heitordemoraesfagundes-star/Project_MO/docs/03_Project_Identity/Project_Brand_Specification.md

# Project MO Brand Specifications

## Brand Identity — V1.0

### Project Name

**Project MO**

## Logo

### Design Concept

A friendly electronic companion represented through a minimalist, PCB-inspired face.

### Core Visual Elements

- Rounded PCB frame
- Continuous circuit traces
- Four corner connection pads
- Simple geometric eyes
- Minimal curved smile

## Primary Colors

| Color | Hex Code |
|---|---|
| MO Mint | `#72D6C1` |
| MO Charcoal | `#182126` |
| MO Teal | `#2D7772` |
| MO Cream | `#F4F1E8` |

## Logo Variants

The Project MO logo is designed in four primary variants:

- Primary
- Light
- Dark
- Monochrome
