heitordemoraesfagundes-star/Project_MO/docs/Development_Log/2026_08_18.md

# Project MO — Development Log

**Date:** 2026-08-18  
**Session:** Decision Log

## Objectives

- Create the Decision Log files
- Polish the files for better presentation

## Work Completed

- Created a Decision Log for all major decisions:
 - DL-001: Project Scope and V1 Definitions
 - DL-002: System Architecture
 - DL-003: Microcontroller Selection
 - DL-004: Interaction & Personality System
 - DL-005: Audio System Design
 - DL-006: Power System Design
 - DL-007: Mechanical & Enclosure Design
 - DL-008: Documentation & Repository Structure

## Decisions Made

- The major decisions were split into eight Decision Logs

## Problems/Blockers

- none

## Next Steps

- Continue with the next stage of Project MO development and implementation.
