heitordemoraesfagundes-star/Project_MO/docs/Development_Log/2026_08_25.md

# Project MO — Development Log

**Date:** 2026-08-25
**Session:** Faceplate Fastening & Front-Control Opening Design

## Objectives

* Complete the main-body and faceplate fastening system
* Verify alignment and interference between the main body, faceplate, and display
* Begin Goal 3 by defining the final front-panel control layout
* Create functional openings for the D-pad and three primary buttons
* Preserve adequate manufacturing clearance without unnecessarily changing the original control geometry

## Work Completed

* Added the following user parameters for the faceplate fastening system:

  * Boss outer diameter: 8 mm
  * Boss depth: 10 mm
  * Pilot-hole diameter: 2.6 mm
  * Pilot-hole depth: 8 mm
  * Screw-clearance diameter: 3.4 mm
* Created four mounting bosses inside the main body
* Positioned the boss centers 11 mm from the nearest side edges, with the two rows located 25 mm and 85 mm from the lower edge
* Added support ribs between the bosses and enclosure walls
* Corrected an extrusion that initially used `BodyDepth` instead of `BossDepth`
* Added four matching 3.4 mm through-holes to the faceplate
* Created construction axes through the corresponding body and faceplate holes
* Verified that matching axes have:

  * Distance: 0.00 mm
  * Angle: 0.00°
* Confirmed that the body and faceplate have no volumetric interference apart from intended coincident contact surfaces
* Confirmed that the display does not interfere with the body or faceplate
* Created a Fusion 360 version checkpoint for the completed Goal 2 assembly
* Completed Goal 2: Main Body and Faceplate
* Began Goal 3 by refining the front-panel layout using the original video as a visual reference
* Imported and positioned the original mesh models for:

  * D-pad
  * Large circular button
  * Small circular button
  * Triangular button
* Changed the display appearance to green and used the Shaded visual style to improve visibility
* Established the approximate control-center positions on the faceplate
* Confirmed that each button uses a narrow stem through the faceplate and a wider retaining flange behind it
* Created local mesh copies because linked mesh components could not be selected by the Mesh Section Sketch tool
* Generated mesh-section sketches for the button stems at the faceplate plane
* Applied 0.30 mm radial clearance to the D-pad and triangular-button profiles
* Corrected the circular measurements after identifying that the first sections referenced the larger retaining flanges rather than the narrow stems
* Defined the circular control openings as:

  * Large circular button: 18.6 mm diameter
  * Small circular button: 10.6 mm diameter
* Copied the completed opening profiles into the `Face_Plate` file
* Cut the D-pad, triangular, small-circle, and large-circle openings through the faceplate
* Visually verified clear gaps between the button stems and their corresponding openings
* Confirmed that the larger exterior caps and retaining flanges remain wider than their openings
* Completed the screen opening and all four primary control openings for Goal 3

## Decisions Made

* Four M3 fasteners will be used to secure the faceplate to the main body
* The body will use 8 mm bosses with 2.6 mm pilot holes, while the faceplate will use 3.4 mm clearance holes
* Goal 2 is considered complete following alignment, interference, and display-fit verification
* The original button meshes will remain reference components rather than being converted into production solids
* Button openings will be based on the narrow pass-through stems, not the exterior caps or retaining flanges
* A nominal radial clearance of 0.30 mm will be used around the button stems
* Minor asymmetry in the triangular opening is acceptable because it follows the original mesh geometry and remains hidden beneath the button cap
* Visual clearance verification is acceptable for the mesh buttons because Fusion 360 cannot reliably include the linked mesh components in normal interference checks
* Goal 3 will remain in progress until the remaining front-panel slot and lower port openings are completed

## Problems/Blockers

* The mounting bosses initially passed through the enclosure because the extrusion accidentally referenced `BodyDepth` rather than `BossDepth`
* Linked button meshes could not be selected using Create Mesh Section Sketch
* Fusion 360 did not provide an Edit in Place option for the linked mesh components
* Temporary local mesh copies were required to generate the button section profiles
* The first circular section measurements captured the retaining flanges instead of the narrower button stems
* The triangular mesh produced a slightly asymmetric fitted profile
* Normal interference checks could not be performed between the faceplate and the linked mesh buttons
* Final physical fit will still depend on real 3D-printing tolerances

## Next Steps

* Save a clean Fusion 360 version containing the completed control openings
* Finish Goal 3 by adding the horizontal slot below the display
* Add the two lower rectangular port openings
* Decide whether V1 requires a separate microphone or status-indicator opening
* Verify the complete front-panel layout against the original visual reference
* Consider printing a small control-opening test coupon before printing the complete faceplate
* After completing Goal 3, begin Goal 4: External Parts
