heitordemoraesfagundes-star/Project_MO/docs/Development_Log/2026_08_29.md

# Project MO — Development Log

**Date:** 2026-08-29  
**Session:** Goal 5 Completion & Goal 6 Assembly/Serviceability Review

## Objectives

* Complete the remaining internal hardware mounts and ventilation features for Goal 5
* Verify that the electronic modules can be installed, removed, and serviced in a practical order
* Confirm button travel, perfboard retention, and cable-connector clearance
* Create and validate the D-pad center pivot
* Complete the first Goal 6 assembly and serviceability checkpoint

## Work Completed

* Completed the 40 mm speaker mounting system using a side cradle aligned with the speaker grille
* Created a snap-style mount for the MAX98357A amplifier near the speaker
* Modeled the button perfboard using the provisional 111.76 × 50.8 × 1.6 mm dimensions
* Positioned seven tactile-switch references beneath the four front controls
* Created 1.5 mm-deep button-flange recesses while preserving 1.5 mm of front-wall material
* Added perfboard standoffs and pilot holes for removable screw fastening
* Added two circular speaker grilles with 37 holes each
* Added rear ventilation using two banks of six horizontal slots
* Verified that the USB opening remains accessible and that the FacePlate can be removed without interference
* Deferred dedicated cable clips and channels to V2 after confirming that flexible wiring can be routed without blocking service access
* Defined the main-body installation order as:

  1. Speaker
  2. Amplifier
  3. ESP32
  4. Display
  5. Display upper retainer
* Defined the FacePlate subassembly order as buttons first, followed by the perfboard
* Confirmed that the display should be removed before servicing the speaker or amplifier
* Confirmed that the ESP32 remains independently accessible
* Added a provisional 15 × 10 × 8 mm connector-clearance volume beneath the perfboard
* Confirmed space for an inward-facing detachable perfboard connector and a flexible 40–50 mm service loop
* Tested the circular and triangular buttons with 0.5 mm of simulated travel and confirmed correct switch engagement
* Measured the D-pad center socket as approximately 2.4 × 2.4 mm with a depth of 2.2 mm
* Measured 5.3 mm from the D-pad underside to the perfboard and defined a 7.5 mm total pivot height
* Created `DPad_Center_Pivot` with:

  * Ø2.0 mm stem
  * 7.5 mm total height
  * 0.8 mm rounded top fillet
  * Ø5 × 1 mm adhesive base flange
* Tested the D-pad at ±2° around both horizontal axes
* Confirmed that each rocking direction activates only one tactile switch
* Confirmed that the D-pad pivot flange does not interfere with the switches
* Verified perfboard screw access and completed the full assembly/serviceability review
* Saved the checkpoint `Goal 6A – Assembly and Serviceability Review Complete`

## Decisions Made

* The speaker, amplifier, ESP32, display, and display retainer will use a deliberate service order rather than being treated as simultaneously accessible
* The display must be removable without disturbing the FacePlate button subassembly
* The perfboard connection will use a detachable inward-facing connector with a flexible service loop
* Dedicated internal cable clips will be deferred to V2 unless physical assembly testing shows that they are necessary
* The D-pad requires a separate center pivot attached to the perfboard
* The D-pad pivot will use a wide adhesive flange so the narrow stem remains stable during repeated use
* Goal 5 is considered complete following the internal-mount, ventilation, connector-access, and interference checks

## Problems/Blockers

* The D-pad did not include a suitable central support in the original button geometry
* The pivot height had to account for both the 2.2 mm socket depth and the measured 5.3 mm gap to the perfboard
* Internal serviceability requires the display to be removed before accessing the speaker and amplifier
* Exact connector dimensions and the final service-loop length must still be verified using the purchased hardware
* The electronic reference models remain provisional and must be checked against the physical components before production printing

## Next Steps

* Begin the Goal 6 manufacturing-readiness review
* Check minimum wall thicknesses, snap clips, screw bosses, and reinforcement fillets
* Verify print orientation and support requirements for every printable component
* Standardize the arm and leg mounting interfaces where practical
* Finalize screw lengths and clearance-hole dimensions
* Run a final full-assembly interference check
* Export the verified print-ready meshes
