heitordemoraesfagundes-star/Project_MO/docs/Development_Log/2026_08_30.md

# Project MO — Development Log

**Date:** 2026-08-30  
**Session:** Goal 6 Manufacturing Readiness, Mesh Export & Print Validation

## Objectives

* Complete the enclosure manufacturing-readiness review
* Verify walls, snap features, bosses, fasteners, limb connections, and FacePlate clearance
* Establish print orientation and support requirements for every V1 part
* Export and organize the final mesh package
* Validate all meshes in PrusaSlicer
* Create a consolidated specification for requesting professional 3D-printing quotes

## Work Completed

* Verified the principal enclosure walls and FacePlate inner wall at 3.0 mm
* Confirmed 1.5 mm of remaining material beneath the button-flange pockets
* Confirmed approximately 1.5 mm minimum spacing around the grille and ventilation openings
* Increased the ESP32 and amplifier snap-hook thicknesses from 0.8 mm to 1.2 mm
* Added 0.4 mm root fillets to the strengthened snap hooks
* Rechecked both snap mounts and confirmed no PCB interference
* Verified a representative screw boss with:

  * 8 mm outer diameter
  * Ø2.6 mm pilot hole
  * Approximately 2.7 mm radial wall thickness
* Applied 0.8 mm fillets only to true concave FacePlate boss-rib junctions
* Rejected fillets on convex enclosure edges when the preview removed material and weakened the geometry
* Used draft and section analysis to review the enclosure walls, internal features, and manufacturing direction
* Established the main-body print orientation with the flat rear exterior on the build plate and the open front upward
* Established the FacePlate print orientation with the visible exterior on the build plate and internal protrusions upward
* Established flat print orientations for the display retainer, button parts, and D-pad pivot
* Established side orientations for both arms and broad-side orientations for both legs
* Standardized the leg peg insertion length from 2.5 mm to 3.0 mm to match the arm connection depth
* Changed the leg sockets to cut through the complete 3 mm enclosure wall
* Confirmed no overlap after the leg-interface revision
* Verified the final limb interfaces as:

  * Arm peg: 6 × 6 × 3 mm
  * Arm socket: 6.4 × 6.4 mm through the 3 mm wall
  * Leg peg: 5 × 5 × 3 mm
  * Leg socket: 5.6 × 5.6 mm through the 3 mm wall
* Confirmed the FacePlate perimeter clearance as 0.50 mm per side on all sides
* Finalized the screw schedule:

  * FacePlate: M3 × 10 mm self-tapping/thread-forming screws
  * Display retainer: M3 × 8 mm self-tapping/thread-forming screws
  * Button perfboard: M2 × 5 mm self-tapping/thread-forming screws
* Verified the corresponding clearance holes:

  * FacePlate and display retainer: Ø3.4 mm
  * Perfboard: Ø2.4 mm
* Confirmed the main-body Ø2.6 mm pilot holes for the M3 screws
* Ran the final assembled interference check and found no interference
* Cleaned the export assembly by hiding construction geometry, analysis overlays, and electronic reference components
* Exported the following new parts as high-refinement 3MF files in millimeters:

  * `Project_MO_Main_Body_V1.3mf`
  * `Project_MO_FacePlate_V1.3mf`
  * `Project_MO_Display_Upper_Retainer_V1.3mf`
  * `Project_MO_DPad_Center_Pivot_V1.3mf`
  * `Project_MO_Left_Arm_V1.3mf`
  * `Project_MO_Right_Arm_V1.3mf`
  * `Project_MO_Left_Leg_V1.3mf`
  * `Project_MO_Right_Leg_V1.3mf`
* Renamed the existing original button meshes to match the Project MO V1 naming convention
* Organized the production meshes under `hardware/enclosure/V1_Final/`
* Saved the Fusion checkpoint `Goal 6B – Manufacturing Review and Mesh Export Complete`
* Used an Original Prusa XL 5T 0.4 mm profile as a temporary large-bed inspection profile
* Disabled the automatically generated wipe tower because the project will be sent to a professional printing service rather than exported as G-code
* Completed PrusaSlicer validation for every printable part:

  * Main body: rear exterior down; targeted support required beneath the lower speaker cradle
  * FacePlate: exterior down; no support required
  * Display upper retainer: flat; no support required
  * D-pad center pivot: flange down; no support required; three copies recommended
  * Arms: side-down; build-plate organic/tree support recommended
  * Legs: broad-side-down; build-plate support and brim required
  * All four buttons: retaining flange down; no support required
* Selected PETG as the preferred V1 printing material
* Defined the quote specification as:

  * FDM/FFF process
  * 0.4 mm nozzle
  * 0.20 mm layer height
  * Four perimeters
  * 20% gyroid infill
  * Five top and bottom layers
  * 100% scale
* Created `Project_MO_V1_3D_Printing_Specification.pdf` containing quantities, orientations, support instructions, critical dimensions, fasteners, and quality requirements

## Decisions Made

* PETG will be requested for the complete V1 printed-parts quote because it provides better toughness and heat resistance than PLA for snap clips, screw bosses, and limb pegs
* The final production package will use 3MF mesh files rather than client-generated G-code
* The original buttons will retain their existing mesh geometry and will not be redundantly re-exported from Fusion
* Left and right arm and leg parts will remain separate replacement files
* The main body requires support only beneath the speaker cradle according to the slicer validation; the display ledge was accepted as printable without generated support
* Arms require support because of their curved undersides, while legs require both support and a brim because of limited bed contact
* Three D-pad center pivots will be ordered because the part is small and easy to lose
* The full enclosure should not be ordered until the exact purchased electronics have been verified

## Problems/Blockers

* The initial default PrusaSlicer printer profile was too small for the approximately 150 × 200 × 60 mm enclosure and produced an out-of-bounds warning
* The temporary XL 5T profile generated a wipe tower that had to be disabled because only single-material geometry inspection was required
* The arm and leg meshes retained their Fusion assembly orientations and required reorientation in PrusaSlicer
* Both arms produced floating-feature warnings without support
* Both legs produced floating-bridge, loose-extrusion, and low-bed-adhesion warnings without support and a brim
* Exact dimensions of the purchased display, ESP32, amplifier, speaker, perfboard, and connectors remain unverified
* A professional 3D-printing supplier and final printing price have not yet been selected

## Next Steps

* Verify the exact purchased components and compare their measurements with the provisional CAD references
* Update any affected mounts or clearances before ordering the full enclosure
* Create or order a small functional fit sample for the limb sockets, button clearance, and screw pilots
* Identify professional 3D-printing suppliers and request comparable PETG quotes using the mesh package and printing specification
* Update the BOM with the selected supplier, material, quantity, price, shipping, and lead time
* Upload the final manufacturing package and both Development Logs to the Project MO GitHub repository
* Continue to physical fit testing, electronics assembly, wiring, firmware, and final documentation after the printed parts arrive
