heitordemoraesfagundes-star/Project_MO/docs/Development_Log/2026_09_11.md

# Project MO - Development Log

**Date:** September 11, 2026  
**Session focus:** Printable-solid verification, 3MF validation, and V1 manufacturing-release packaging

## Session objective

Convert the completed enclosure design into a clear and reproducible manufacturing package by standardizing part names, verifying every revised printable solid, validating the final 3MF exports in PrusaSlicer, preserving the editable Fusion assembly, and updating the production documentation.

## Work completed

### 1. Printable-part naming and organization

- Standardized the principal enclosure-part names around the `Project_MO_V1` naming convention.
- Confirmed the final part identities for:
  - Main Body
  - FacePlate
  - Display Upper Retainer
  - Four position-specific Perfboard Retainers
  - D-pad, large circular, small circular, and triangle buttons
  - D-pad Center Pivot
  - Left and right arms
  - Left and right legs
- Organized the four perfboard retainers as four independent top-level components.
- Assigned the retainer locations as viewed from the inside of the FacePlate:
  - `Perfboard_Retainer_Upper_Left`
  - `Perfboard_Retainer_Upper_Right`
  - `Perfboard_Retainer_Lower_Left`
  - `Perfboard_Retainer_Lower_Right`
- Used visibility isolation to confirm that each retainer is an independent printable solid.

### 2. FacePlate and Main Body release checks

- Confirmed that the FacePlate contains one production body and no reference solid inside its Bodies folder.
- Rechecked the FacePlate interfaces:
  - FacePlate-to-body clearance holes: **3.4 mm**
  - Perfboard support-boss outer diameter: **7.0 mm**
  - Perfboard support-boss pilot diameter: **1.6 mm**
  - Pilot/support depth: **4.5 mm**
- Confirmed that all control, display, switch, and screw openings pass through as intended.
- Confirmed that the Main Body contains one production body and no reference solid inside its Bodies folder.
- Rechecked the Main Body interfaces:
  - Main switch cutout: **20.0 mm**
  - FacePlate mounting pilots: **2.6 mm**
  - Overall slicer envelope: approximately **150 x 200 x 65 mm**
- Verified that the Main Body vents, USB opening, internal supports, and mounting features remained present in the production export.

### 3. Display Upper Retainer verification

- Renamed the source design `Project_MO_V1_Display_Upper_Retainer`.
- Confirmed that it contains one continuous production body.
- Confirmed both mounting holes at **3.4 mm diameter**.
- Confirmed that the continuous bar and both lower contact/support pads remain attached.
- Found no timeline warnings or unintended reference solids.

### 4. Perfboard-retainer manufacturing checks

- Confirmed all four M2 clearance holes at **2.2 mm diameter**.
- Confirmed the added **R2.0 mm side fillets**.
- Measured approximately **2.90 mm** of minimum side material around the inspected mounting hole.
- Measured approximately **2.759 mm** of minimum bottom material around the inspected mounting hole.
- Finalized the retainer overlap onto the perfboard at **2.929 mm**.
- Confirmed that this overlap does not cover any required solder pad.
- Approved all four retainers as separate manufacturing-ready solids.

### 5. Individual 3MF export

- Exported every perfboard retainer as an individual 3MF file.
- Re-exported the four control bodies from the shared Fusion button document as true 3MF files:
  - D-pad Button
  - Large Circular Button
  - Small Circular Button
  - Triangle Button
- Retained one D-pad Center Pivot file with a required print quantity of three.
- Re-exported the updated Main Body, FacePlate, and Display Upper Retainer.
- Reused the previously verified arm and leg exports because those designs had not changed.

### 6. PrusaSlicer validation

- Imported the four perfboard retainers together and confirmed that PrusaSlicer recognized four independent objects.
- Sliced the retainers successfully with open screw holes, connected tabs, and no floating toolpaths.
- Imported and sliced all four buttons as separate objects with their retaining flanges on the build plate.
- Confirmed complete button toolpaths, no floating geometry, and no required support.
- Imported and sliced the D-pad Center Pivot with its flange on the bed and stem vertical.
- Confirmed that the pivot slices as one continuous part; retained an optional small brim recommendation for the real print.
- Imported and sliced the Main Body with the rear exterior on the build plate and open side upward.
- Confirmed the Main Body at approximately **65 mm** print height with complete walls, vents, openings, and internal mounts.
- Imported and sliced the FacePlate with its visible exterior on the bed and internal bosses upward.
- Confirmed all FacePlate openings and bosses in the sliced preview with no support required.
- Imported and sliced the Display Upper Retainer with complete holes and connected support tabs.
- Treated the unchanged arms and legs as still valid based on their previous completed verification.

### 7. Final manufacturing-folder organization

- Organized `hardware/enclosure/V1_Final/` into:
  - `3MF_Final`
  - `Legacy_STL`
  - `Old_Versions`
  - `Fusion_Source`
- Moved the four older STL button exports into `Legacy_STL`.
- Moved superseded Main Body and Display Upper Retainer 3MF exports into `Old_Versions`.
- Confirmed that `3MF_Final` contains **16 unique production 3MF files**.
- Confirmed that the file set produces **18 physical pieces** because the D-pad Center Pivot is printed three times.

### 8. Editable Fusion archive

- Created the final Fusion version checkpoint for the manufacturing-release candidate.
- Used the Autodesk Fusion web project interface to request a native Fusion Archive export.
- Downloaded the linked assembly as an F3Z archive.
- Renamed the archive:
  - `Project_MO_V1_Manufacturing_Release.f3z`
- Confirmed the archive as a valid Autodesk Fusion file with a size of approximately **10.7 MB**.
- Assigned the archive to the `Fusion_Source` folder so that the editable assembly and linked references remain preserved.

### 9. Manufacturing documentation update

- Created `PRINT_MANIFEST.md` containing:
  - All 16 final 3MF filenames
  - Required quantity for every part
  - Total of 18 physical pieces
  - Editable F3Z archive location
  - Final interface dimensions and verification status
- Updated the original 3D Printing Specification from Revision 1.1 to **Revision 1.2**.
- Added the four perfboard retainers and updated the final quantities.
- Updated the button-perfboard fastener specification from the obsolete M2 x 5 mm / 2.4 mm arrangement to:
  - **M2 x 8 mm screws**
  - **2.2 mm retainer clearance holes**
  - **1.6 mm x 4.5 mm FacePlate pilots**
  - Approximately **4.4 mm thread engagement**
- Updated the main enclosure envelope to approximately **150 x 200 x 65 mm**.
- Added the finalized **2.929 mm perfboard overlap** and retainer material checks.
- Added the **20.0 mm switch cutout**, approximately 19.6 mm switch body, 22.9 mm flange, and provisional internal clearance envelope.
- Removed the obsolete STL meter-to-millimetre correction warning because the final button files are true 3MF exports at the correct scale.
- Added final release-package, verification, and pre-production validation notes.

## Decisions made

1. Treat **2.929 mm** as the final V1 perfboard-retainer overlap because it does not obstruct required solder pads.
2. Store each position-specific perfboard retainer as a separate 3MF file.
3. Keep one editable Fusion source document containing all four retainer components.
4. Use 3MF as the final production mesh format and retain the old STL files only as legacy backups.
5. Maintain 16 unique production files and print the D-pad Center Pivot three times for 18 total pieces.
6. Reuse the previously verified arm and leg exports because their geometry has not changed.
7. Preserve the complete linked Fusion assembly as an F3Z archive.
8. Keep cable-management additions outside the V1 manufacturing release.

## Verification status

| Item | Status |
| --- | --- |
| Four perfboard retainers are separate solids | Passed |
| Perfboard-retainer final overlap | 2.929 mm approved |
| Required solder pads remain accessible | Passed |
| Four retainers re-imported and sliced | Passed |
| Four buttons re-imported and sliced | Passed |
| D-pad Center Pivot re-imported and sliced | Passed |
| Main Body re-imported and sliced | Passed |
| FacePlate re-imported and sliced | Passed |
| Display Upper Retainer re-imported and sliced | Passed |
| Arms and legs | Previously verified; unchanged |
| Final production mesh count | 16 unique 3MF files |
| Total printed-piece count | 18 |
| Final Fusion archive | F3Z export completed |
| Printing manifest | Completed |
| Printing specification | Updated to Revision 1.2 |

## Final release files

- `3MF_Final/` - 16 approved production meshes
- `Fusion_Source/Project_MO_V1_Manufacturing_Release.f3z`
- `PRINT_MANIFEST.md`
- `Project_MO_V1_3D_Printing_Specification_Rev1.2_EN.pdf`
- `Legacy_STL/` - backup only
- `Old_Versions/` - backup only

## Remaining work

- Copy the completed Development Logs into the project documentation structure and commit the release documentation to GitHub.
- Obtain and physically measure the selected power switch, especially its total depth and terminal projection.
- Receive and inspect the exact display, ESP32, amplifier, speaker, microphone, perfboard, and other purchased components.
- Print small fit coupons for the 20 mm switch opening, screw pilots, button clearances, and limb peg/socket interfaces where practical.
- Request or compare professional printing quotes using Revision 1.2 of the specification.
- Complete component-arrival and bench testing before final assembly.

## Session outcome

Project MO V1 reached the manufacturing-release-candidate stage. Every changed printable part was organized, exported as a real 3MF file, re-imported, and successfully sliced. The unchanged limbs retained their previous verification. The production folder now contains a controlled 16-file mesh set for 18 printed pieces, older exports are separated from production files, the linked Fusion assembly is preserved as an F3Z archive, and the printing specification and manifest reflect the final V1 mechanical design.
