heitordemoraesfagundes-star/Project_MO/docs/Development_Log/2026_08_01.md

# Project MO — Development Log

**Date:** 2026-08-01  
**Session:** Engineering Decisions

## Objectives

- Decide the project main controller

## Work Completed

- Decided main controller

## Decisions Made

- Main controller: ESP32

## Problems / Blockers

- Controler must handle multiple pheripherals while remaining affordable

## Next Steps

-  Write PDS document
