heitordemoraesfagundes-star/Project_MO/docs/Development_Log/2026_08_02.md

# Project MO — Development Log

**Date:** 2026-08-02  
**Session:** Product Design Specification

## Objectives

- Write PDS document

## Work Completed

- Created PDS document 

## Decisions Made

- Decided desing oriention

## Problems / Blockers

- None

## Next Steps

- Create BOM file.
- Choose first components.
- Decide all necessary information.
