heitordemoraesfagundes-star/Project_MO/docs/Development_Log/2026_08_06.md

# Project MO — Development Log

**Date:** 2026-08-06  
**Session:** BOM_Final_Version

## Objectives

- Complete the missing details on the BOM.
- Add additional components.
- Add unit price, weight, supplier and link to every .

## Work Completed

- Filled the missing details.
- Added C-020 to C-028.
- Added unit price, weight, supplier and link.

## Decisions Made

- All 3D prited parts will have their price added only after modifications.
- All 3D printed parts should come from the same supplier if possible.

## Problems / Blockers

- Some item's weight needed to be estimated.
- 3D printed parts price couldn't be filled.

## Next Steps

- Finish 3D part modification to fill in the missing details.
- Create GitHub repository structure.
- Draft the project README.
