heitordemoraesfagundes-star/Project_MO/docs/02_Design/Hardware_Specification_Document.docx

Hardware Selection Document(HSD):

1. Hardware Philosophy:

#Design Goals:

-low cost;

-high reliability;

-easy to programm;

-easy to replace;

-modular design;

-expandable for future versions.

2. System Overview:

#The robot can be divided into six main hardware systems:

-power system;

-main controller;

-input;

-output;

-communication;

-mechinical structure.

3. Main controller(ESP32 DevKit V1):

#Pros:

-cheap;

-Wi-fi and Bluetooth connection;

-dual-core processor;

-plenty GPIO pins;

-huge community;

-compatible with arduino IDE;

-lower power consumption;

-easy to replace/upgrade.

#Cons:

-unnable to run AI models.

4. Display System(2.4 inch TFT LCD):

#Pros:

-color;

-larger animations;

-better face expression and better visual appeal.

#Cons:

-slightly more expensive than other options(R$50-50)

5. Audio System(DF Player_Mini + Speaker):

#Pros:

-plays MP3 files;

-easy to program;

-excellent sound;

-SD card storage;

-very common;

#Cons:

-requires audio files to be recorded beforehand.

6. Input System:

#Buttons:

-start;

-menu;

-confirm;

-personality;

-games(future addition).

7. Sensors:

#Ultrasonic Sensor(HC-SR04):

-detect user approaching;

-eye traking (possible future addition).

#Touch sensor:

-for future additions

#Light Sensor:

-know the diffeence between lights on and off;

-not essencial;

#Microphone:

-for future versions;

8. Lighting:

#WS2812B RGB LEDs:

-programabble;

-colorful;

-enhances personality;

-low cost.

#Possible uses:

-charging animation;

-mood;

-startup animation.

9. Power:

#USB-C (for V1-V2):

-simple;

-reliable;

-easy debugging;

#Battery (for V2-V3):

-makes the robot more portable;

10. Mechinical Components:

-M3 screws;

-brass heat-set inserts;

-magnets/hidden screws (for easy maintenance);

-small standoff/spacers;

-cable ties or adhesive clips for cable managing.

11. Debbug mode:

-add debug mode to check connections.
