heitordemoraesfagundes-star/Project_MO/docs/02_Design/Mechanical_Design_Specification.docx

## Mechanical Design Specification (MDS)

### Mechanical Requirements

- Display must be removable.
- No permanent glue for major components.
- Speaker accessible.
- Cable routing channels.
- Easy maintenance.
- Rear panel removable.
- Components mounted with screws whenever possible.

Mechanical Architecture:

## Module A

### Display Module

Contains:

- TFT Display
- Faceplate
- Mounting Frame

This module should be removable independently.

## Module B

### User Interface Module

Contains:

- Front Buttons
- Push Mechanisms
- PCB (future)

## Module C

### Main Electronics Module

Contains:

- ESP32
- DFPlayer
- Voltage Distribution
- Connectors

## Module D

### Audio Module

Contains:

- Speaker
- Acoustic Chamber

## Module E

### Rear Service Panel

Contains:

- USB
- Power
- SD Card Access

Modifications:

1. The front buttons:

-Instead of:

*button -> switch;

-Use:

*button -> spring -> guide -> microswitch;

*smoother feel + consistent travel + easier replacement;

2. Cable routing:

-Clear and easily replicable;
