heitordemoraesfagundes-star/Project_MO/docs/02_Design/Project_Brand_Specification.docx

Project MO Brand Specifications:

PROJECT MO

Brand Identity — V1.0

Project Name:

Project MO

Logo:

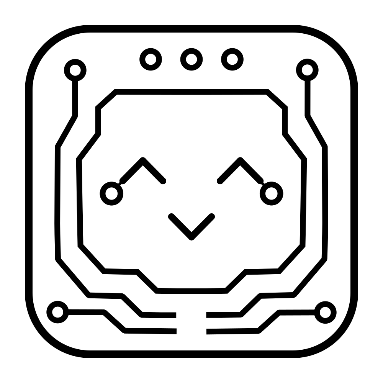
[picture p1: figure]
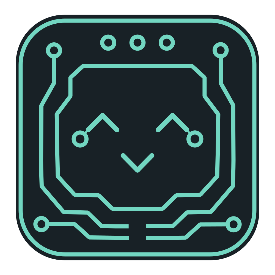
[picture p2: figure]
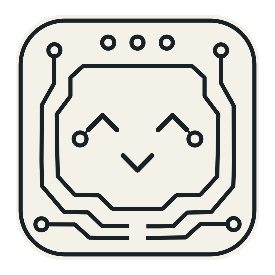
[picture p3: figure]
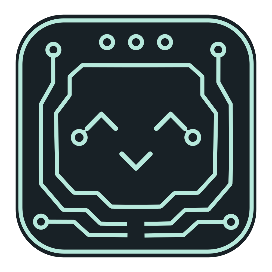
[picture p4: figure]

Design Concept:

A friendly electronic companion represented through

a minimalist PCB-inspired face.

Core Visual Elements:

• Rounded PCB frame

• Continuous circuit traces

• Four corner connection pads

• Simple geometric eyes

• Minimal curved smile

Primary Colors:

MO Mint #72D6C1

MO Charcoal #182126

MO Teal #2D7772

MO Cream #F4F1E8

Logo Variants

• Primary

• Light

• Dark

• Monochrome
