heitordemoraesfagundes-star/Project_MO/docs/02_Design/System_Design_Document.docx

System Design Document(SDD):

1. System Overview:

#Purpose:

The purpose of this system is to develop an interactive robotic prototype inspired by the BMO character from Adventure Time. The system will integrate mechenical design, enbedded electronics and software programming to create a device cappable of interacting with users trough visual, audio and physical interfaces;

2. System Architecture:

-The robot will be divided into five major subsystems:

USER

↓

Interaction Interface

↓ ↓ ↓

Buttons Sensors Microphone

↓

ESP32 Controller

↓ ↓ ↓

Display Audio Lighting

3. Hardware Architecture:

a) Main controller:

-ESP32 Microcontroller

#Functions/Responsibilities:

-The main controller will:

*process user inputs;

*control outputs;

*manage communication between components;

*execute the robots personality logic;

#Reasons for selection:

-The ESP32 was selected because it provides:

*sufficient processing power;

*low cost;

*Integrated Wi-fi/Bluetooth;

*compatibility with many sensors and modules.

b) Visual interface system:

#Possible components:

-OLED display;

-LCD display;

-LED indicators;

#Functions/Responsibilities:

-facial expression;

-animations;

-status indications;

c) Audio System:

#Possible components:

-speaker;

-audio module;

#Fuctions/Responsibilities:

-programmed responses;

-sound effects;

-notifications;

d) Input system:

#Possible components:

-Physical buttons;

-Distance sensor;

-Microphone;

# Fuctions/Responsibilities:

-menu selections;

-trigger responses;

-detect user presence;

-voice interaction;

e) Power system:

#Baterry powered X USB powered:

-USB power:

*easier debugging;

*safer;

*simpler;

4. Sofware Architecture:

a)Input processing:

#Receive:

-button presses;

-sensor data;

b)Personality engine

#Situation -> Response:

-Example:

-single button press = happy expression;

-repeated button presses = angry/ anoyed expression;

c) Output control:

#Controls:

-display;

-audio;

-leds.

5. Personality design:

a)Happy:

#Visual:

-smiling face :) ;

#Audio:

-cheerful response;

b) Curious:

#Visual:

-thinking expression;

#Audio:

-question/comment;

-fun trivia/information;

c) Angry:

#Visual:

-angry expression >:( ;

#Audio:

-irritated/annoyed voice;

d)Sleep mode:

#Visual:

-closed eyes;

#Audio:

-no audio/ snoring sound;

6. Possible future improvements:

#Possible additions:

-voice recognition;

-AI integration;

-autonomous behaviour;

-wireless comunication;

-custom PCB
