heitordemoraesfagundes-star/Project_MO/research/Inspiration.docx

Original video name:

# “I made a real BMO local AI agent with a Raspberry Pi and Ollama”

# Original video link:

https://youtu.be/l5ggH-YhuAw?si=dqu8FAm8gZTQALl-

Creators name: “brenpoly”
