heitordemoraesfagundes-star/Project_MO/docs/Development_Log/2026_08_17.md

# Project MO — Development Log

**Date:** 2026-08-17  
**Session:** Repository Organization

## Objectives

- Finalize the Project MO README.
- Make sure the README accurately reflects the current repository structure.
- Organize the project documentation on GitHub.
- Establish a system for recording daily development progress.
- Establish a system for recording important project and engineering decisions.

## Work Completed

- Uploaded all six completed project documents to GitHub.
- Converted the project documents from .docx to .md.
- Organized the documents into appropriate documentation categories
- Verified that the README links are working correctly.
- Established the planned Development_Log folder for chronological project records.
- Established the planned Design_Decisions folder for important project decisions.

## Decisions Made

- Markdown will be used for the main text-based documentation on GitHub.
- The README will serve as the main entry point to the Project MO repository.
- Development sessions will be recorded using individual dated Markdown files.
- Important decisions will be recorded separately from daily development logs.
- The README will be treated as a living document and updated as Project MO develops.
- The V1 scope remains focused on a stationary desktop companion, with movement outside the scope of V1.
- The repository will keep the Project MO name and finalized logo as its project identity.

## Problems/Blockers

- none

## Next Steps

- Create the Design_Decisions folder and begin documenting major decisions already made.
- Continue reviewing the repository structure and improve it where necessary.
- Begin preparing for the mechanical design phase.
- Identify all modifications required to the existing BMO-inspired 3D model before calculating final 3D-printing costs.
- Eventually begin the enclosure modification and prototyping process.
