heitordemoraesfagundes-star/Project_MO/BOM/Project_MO_V1_Components_BOM_Rev1.12.xlsx

ID | Subsystem | Component | Purpose | Selected Part | Qty | Priority | Purchased | Tested | Notes | Unit Price(BRL) | Supplier | Link | Weight (grams) | Connection/Interface
C-001 | Control | Microcontroller | Main system controller | DOIT ESP32 ESP-WROOM-32 DevKit V1, 30-pin, CP2102, Micro-USB | 1 | Required | Yes — received | Passed — USB/serial and firmware upload | Physical board received and identified as a DOIT ESP32 DEVKIT V1 with the classic ESP32 module and 30-pin layout. Arduino IDE 2.3.10 was configured with the official Espressif esp32 package 3.3.11. The board was detected on COM3; firmware upload, Serial Monitor communication and the Project MO command prototype all passed. Physical measurement and enclosure fit confirmation remain pending. | BRL 59.90 | SARAVATI | https://www.saravati.com.br/placa-esp32-wifi-bluetooth-devkit-v1-30-pinos.html | TBD after purchase | Micro-USB / GPIO / UART / I²S
C-002 | Display | HMI Display | Face animations and user interface | Nextion Intelligent 5.0-inch NX8048P050-011R resistive HMI, 800 x 480, without enclosure | 1 | Required | No | No | Final display selected. PCB: 136.9 x 84.0 mm; LCD outline: 120.7 x 75.8 mm; active area: 108.0 x 64.8 mm; approximately 130 g; 5 V / 1 A recommended supply; XH2.54 4-pin UART (GND, RX, TX, +5 V). CAD fit, active-area alignment, supports, retainer, plug and filleted cable route verified. Minimum plug/cable clearance to the display support is 4.10 mm; no body or speaker interference; display can be inserted with the cable attached. Price converted using BCB rate of BRL 5.1273006 per USD on 2026-09-02: USD 63.90 = BRL 327.66. Checkout with standard shipping: USD 74.51 = BRL 382.05; plus BRL 15 Correios fee gives BRL 397.05 before possible import taxes, card spread and IOF. | BRL 327.66 | ITEAD official store | https://itead.cc/product/5-0-nextion-intelligent-series-hmi-touch-display/ | ~130 g | XH2.54 4-pin UART + 5 V; microSD up to 32 GB
C-003 | Audio | Speaker | Audio output | 40CCG08HX, 40 mm diameter, 19 mm depth, 8 ohm, 3 W nominal | 1 | Required | No | No | Listing specifications confirmed: 40 mm diameter, 19 mm depth, 8 ohm, 3 W nominal / 4 W maximum, 120 Hz-15 kHz. CAD has sufficient rear clearance; verify solder-tab orientation on the physical unit. | BRL 9.69 | Mercado Livre | https://www.mercadolivre.com.br/alto-falante-1-12--8-ohms-3w--40ccg08hx/up/MLBU770728140 | ~15 g | Amplified analog audio
C-004 | Audio | Audio Amplifier | Amplify ESP32 audio | AITRIP MAX98357A I²S mono Class-D amplifier module, 17 × 17 mm | 1 | Required | No | No | Final amplifier selected. Compatible with the regulated 5 V rail and the 8 Ω / 3 W speaker; expected maximum output is approximately 1.8 W into 8 Ω. CAD mounting verified: vertical U-shaped edge holder supports both sides and the bottom, preventing downward movement when upright; top and speaker-facing side remain open for insertion and wiring. Holder provides 0.20 mm clearance per side and chamfered entry edges. Assembly path and body interference checks passed. Recheck physical PCB dimensions and adjust holder tolerance after delivery if required. Connect speaker only across SPK+ and SPK−; neither output is ground. | BRL 38.95 | Mercado Livre | https://www.mercadolivre.com.br/modulo-amplificador-de-audio-aitrip-max98357-i2c-i2s-dac-3w/p/MLB2054404263 | ~2 g | 5 V power; I²S (BCLK/LRC/DIN) from ESP32; mono BTL speaker output
C-005 | Input | Tactile Push Buttons | User interaction | C&K KSA0M911LFTR momentary SPST-NO through-hole tactile switch | 10 purchased (7 used + 3 spares) | Required | No | No | Final switch selected. Approximate body envelope: 7.4 × 7.4 mm; total actuator height above PCB: 4.70 mm. Four through-hole terminals use a 7.62 × 5.08 mm center pattern, compatible with the 2.54 mm perfboard grid; provisional CAD terminals are Ø0.80 mm and pass through the Ø1.00 mm holes. Seven switches are installed: four for the D-pad and three for the individual face buttons; the MOQ 10 pack provides three spares. CAD verification passed with 0.30 mm resting clearance. Each D-pad direction reaches only its intended switch during approximately 2–5° rocking, and the center pivot was extended to match the lowered PCB. Recheck the physical terminal shape, actuator height/travel and feel after delivery. Price converted at the existing BOM rate of BRL 5.1273006 per USD: USD 0.692 each = BRL 3.55 each; MOQ 10 = BRL 35.48 before shipping/import costs. | BRL 3.55 each; BRL 35.48 / 10 | Newark Brasil | https://www.newark.com/pt-BR/c-k-components/ksa0m911lftr/tactile-switch-0-05a-32vdc-300gf/dp/29AK0576 | TBD | GPIO; SPST-NO through-hole
C-006 | Power | USB-C Power Input | External 5 V power input | Geekworm / eleUniverse YG003 USB-C female breakout, 5 V / 3 A | 1 | Required | No | No | Reported 13 x 18 x 5 mm envelope integrated beside the ESP32 with a separate rear opening. Socket recess and profile clearance: 0.30 mm. Internal cradle and anti-drop ledges added; interference checks passed. Current manufacturer base price: USD 2.90 before shipping/import costs. Recheck all dimensions against the physical board before the final production print. | TBD | Geekworm / eleUniverse | https://geekworm.com/products/usb-type-c-female-board | TBD | 5 V / 3 A power (VBUS/GND); dual 5.1 kohm CC pull-downs
C-007 | Power | Voltage Regulation | Provide regulated logic power | ESP32 onboard 3.3 V regulator; shared 5 V input rail | 1 | Required | — | — | ESP32 regulator is for 3.3 V logic only. Calculated design allowance is approximately 2.64 A; use a regulated 5 V / 3 A main supply for the display, amplifier and controller. | Included / TBD | — | — | — | 5 V / 3.3 V power
C-008 | Mechanical | Main Body | Robot enclosure and integrated internal supports | Custom FDM 3D-printed main body | 1 | Required | No | No | Final CAD and print orientation verified; includes integrated vents and speaker cradle | Pending print quote | 3D-print supplier | Pending supplier quote | TBD | Mechanical
C-009 | Mechanical | FacePlate | Front closure and visible control/display openings | Custom FDM 3D-printed FacePlate | 1 | Required | No | No | Final CAD and print orientation verified | Pending print quote | 3D-print supplier | Pending supplier quote | TBD | Mechanical / M3 fasteners
C-010 | Mechanical | Printed Control Caps | External user controls | D-pad, large circular, small circular and triangular printed controls | 4 | Required | No | No | Original button meshes require PrusaSlicer's detected meter-to-millimeter unit correction; do not scale twice | Pending print quote | 3D-print supplier | Pending supplier quote | TBD | Mechanical / tactile switches
C-011 | Hardware | Self-Tapping Fasteners | Enclosure and internal assembly | Pan-head Phillips self-tapping screws: M3 × 10 mm, M3 × 12 mm and M2 × 8 mm | 10 used (extras recommended) | Required | No | CAD verified; supplier pending | Final V1 list: 4 × M3 × 10 mm for FacePlate-to-body mounting; 2 × M3 × 12 mm for the display upper retainer; 4 × M2 × 8 mm for the removable perfboard retaining tabs. FacePlate/body joint uses Ø3.4 mm clearance holes in the FacePlate and Ø2.6 mm pilot holes in the body. Display retainer uses Ø2.6 mm pilot holes. Perfboard tabs use Ø2.2 mm clearance holes and the Ø7 mm bosses use smooth Ø1.6 mm pilot holes. The M2 × 8 mm screw crosses a 3.60 mm stack before the pilot and provides approximately 4.40 mm engagement; the total distance to the exterior FacePlate surface is 10.70 mm. Do not model threads. Require pan/rounded heads with flat undersides; countersunk heads would require a CAD countersink. | TBD | Local fastener/electronics store preferred | TBD | TBD | Assembly hardware
C-012 | Wiring | 20 AWG Power Hook-Up Wire | Internal 5 V and ground distribution | 20 AWG stranded copper flexible hook-up wire, red and black | As needed | Required | No | Specification selected; supplier not fully verified | Use for the main 5 V and GND runs between the USB-C input, protection stage, display, ESP32 and amplifier. Prefer flexible stranded copper; silicone insulation is desirable but not mandatory for V1. Keep red for +5 V and black for GND. Verify conductor material and insulation type before purchase. | BRL 22 | Mercado Livre | https://produto.mercadolivre.com.br/MLB-1669148499-2-metros-fio-cabo-20awg-silicone-vermelho-ou-preto-_JM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 (https://www.usinainfo.com.br/cabo-flexivel/cabo-flexivel-tiaflex-5m-fio-050mm-20awg-azul-2683.html) | ~40 g / 5 m | 5 V power / ground
C-013 | Wiring | Internal Connectors | Optional serviceable internal connections | No separate JST connector kit for V1; direct soldered wiring with heat-shrink | 0 for V1 | Future / V2 | — | — | Removed from the lean V1 purchasing list. Direct soldered joints reduce cost and component count. Reconsider keyed service connectors in a later version if modular replacement becomes necessary. | Not applicable | — | — | — | Direct soldered interconnect
C-014 | Storage | MicroSD Card | Transfer Nextion HMI firmware and assets | SanDisk Ultra 32 GB microSDHC UHS-I Class 10, SDSQUNR-032G-GN3MA, with SD adapter | 1 | Required for setup | Yes — ordered | Delivery and read/write test pending | Purchased for Nextion project transfer. Reserve the card for the display's built-in microSD slot during V1 setup; no separate ESP32 microSD reader module is planned. After delivery, verify capacity, format as FAT32 if required by the display workflow, copy the HMI file and verify the transfer. | BRL 48.24 | PHILOS / Mercado Livre | https://www.mercadolivre.com.br/cartao-de-memoria-sandisk-sdsqunr-032g-gn3ma-ultra-com-adaptador-sd-32gb/p/MLB14736452 | ~0.25 g | microSDHC / removable storage
C-015 | PCB | Perfboard | Mount and interconnect V1 controls/electronics | SmartKits FR-4 single-sided perfboard, 100 × 150 × 1.6 mm, 2.54 mm pitch, Ø1.0 mm holes | 1 | Required | No | Supplier specifications and revised mounting CAD verified | Final perfboard selected. Cut a 44 × 20-hole section measuring 111.76 × 50.80 mm; hole centers are spaced 2.54 mm apart and the outer hole centers are 1.27 mm from every cut edge. Board is FR-4, 1.6 mm thick, with individual single-sided copper pads. The earlier through-grid screw concept was rejected because the Ø1.0 mm board holes cannot pass M2 screws. Revised mounting uses four Ø7 mm support bosses under the board plus four removable printed corner tabs on the opposite face. Each tab has a smooth Ø2.2 mm clearance hole and each boss has a smooth Ø1.6 mm pilot hole for an M2 × 8 mm self-tapping screw. Measured boss overlap at the board corner is 2.173 mm; board-corner gap and assembly/interference checks passed. Cutting FR-4 produces hazardous fiberglass dust; use suitable PPE and workshop dust control. | BRL 12.90 | SmartKits | https://www.smartkits.com.br/placa-perfurada-fibra-de-vidro-face-simples-10x15cm | TBD after cutting | 2.54 mm solder-pad grid / printed retaining tabs
C-016 | PCB | Custom PCB | Future consolidated electronics assembly | Custom PCB | 0 for V1 | Future / V2 | — | — | Deferred to V2; not part of the V1 purchasing total | Not applicable | — | — | — | PCB
C-017 | Audio | I²S Microphone | Voice-command audio input | INMP441 omnidirectional I²S MEMS microphone module, round breakout, approximately 14 × 14 × 2 mm | 1 | Required | Yes — received | Visual inspection passed; audio test pending | Physical INMP441 round six-pin breakout received and identified from the labeled SCK, WS, L/R, SD, VDD and GND pads. Male header pins were included but remain unsoldered until mounting orientation and GPIO allocation are finalized. Operate from 3.3 V only; L/R must be tied to GND or 3.3 V during testing. A soldering iron still needs to be bought or borrowed. Physical fit and I²S audio tests remain pending. | BRL 49.99 | HOVEYO Official Store / Mercado Livre | https://www.mercadolivre.com.br/microfone-inmp441-i2s-arduino-esp32-raspberry-pi-mems-studio/up/MLBU3986362028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 (https://www.mercadolivre.com.br/modulo-microfone-omnidirecional-mems-interface-i2s-inmp441/up/MLBU1974813277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) | ~0.7 g | 3.3 V power; I²S (SCK/WS/SD); L/R channel select
C-018 | Indicators | Status LED | Startup and diagnostic indication | 3 mm diffused green LED | 1 | Optional | No | No | Include an appropriate series resistor in the electrical design | BRL 17 (100 units) | Mercado Livre | https://www.mercadolivre.com.br/100-pecas--led-3mm-verde-difuso-promocao/up/MLBU1410458233 | ~0.1 g | GPIO
C-019 | Power | On/Off Switch | Disconnect system power | Mini SPDT slide switch, SS12D00G3 or equivalent | 1 | Recommended | No | No | Verify body dimensions, mounting method and DC current rating before purchase | TBD | TBD | TBD | TBD | Power
C-020 | Mechanical | Ventilation Openings | Provide enclosure airflow | Integrated into the 3D-printed main body | Included | Required | — | — | Not a separate printed or purchased component; cost included in C-008 | Included in C-008 | — | — | — | Mechanical
C-021 | Hardware | Brass Heat-Set Inserts | Optional reusable threaded joints | M3 x 4 x 5 mm brass heat-set inserts | 0 for current V1 | Optional alternative | No | No | Current V1 fastener design uses self-tapping/thread-forming screws; retain only as a future alternative | BRL 10 (10 units) | Mamute Eletrônica | https://www.mamuteeletronica.com.br/kit-10-insertos-metalicos-de-latao-rosca-m3-para-impressao-3d-31756 | ~0.3-0.4 g each | Assembly hardware
C-022 | Mechanical | Adhesive EVA Support Feet | Support the enclosure without loading the cosmetic legs | Round self-adhesive EVA feet, Ø20 × 10 mm, black | 4 | Required | No | Listing and CAD envelope verified; compression test pending | Selected V1 candidate from a 16-piece kit. The lowest leg point is approximately 5.5 mm beyond the enclosure support face, so a nominal 10 mm foot provides about 4.5 mm unloaded clearance before EVA compression. Four Ø20 × 10 mm CAD reference cylinders fit without overlap or interference and their contact faces must remain coplanar. Confirm the physical compressed height and check for rocking after installation. | TBD | LOJAGCO / Mercado Livre | https://www.mercadolivre.com.br/protetor-adesivo-cadeira-pe-sofa-mesa-aparador-kit-16-pecas/up/MLBU4422575356 | TBD | Adhesive mechanical support
C-023 | Mechanical | Display Upper Retainer | Secure the top and rear of the display | Custom FDM 3D-printed display upper retainer | 1 | Required | No | No | Revised 6 mm screw-path region and rear-support extension; largest flat rear-support face on build plate | Pending print quote | 3D-print supplier | Pending supplier quote | TBD | Mechanical / M3 x 12 mm
C-024 | Mechanical | D-pad Center Pivot | Support D-pad movement | Custom FDM 3D-printed center pivot | 3 | Required | No | No | Print 5 mm flange on build plate with 2 mm stem vertical | Pending print quote | 3D-print supplier | Pending supplier quote | TBD | Mechanical
C-025 | Wiring | Micro-USB Data/Power Cable | Program and bench-test the ESP32 | USB-A to Micro-USB data-and-power cable, approximately 1 m | 1 | Required for testing | Already owned | Passed — COM3/data/upload verified | Existing USB-A to Micro-USB cable is confirmed to carry data and power. Windows detected the ESP32 as COM3, Arduino IDE successfully uploaded firmware, and two-way Serial Monitor testing passed. Keep this cable as the V1 programming and bench-test cable. | Already owned | Existing cable | — (https://www.amazon.com.br/Ugreen-Adaptador-Conversor-para-Note/dp/B07HD3RN9G) | TBD | USB 2.0 Micro-B / data + 5 V
C-026 | Assembly | Double-Sided Foam Tape | Mount non-screwed internal components | 1 mm double-sided foam mounting tape | As needed | Recommended | No | No | Use only where it will not obstruct vents, connectors, service access or heat dissipation | BRL 26 | Mercado Livre | https://www.mercadolivre.com.br/fita-dupla-face-espuma-multiuso-25mmx10m-fachada-porta-acm/up/MLBU3258063208 | Negligible | Assembly hardware
C-027 | Electrical Assembly | Heat-Shrink Tubing | Insulate and reinforce soldered connections | 560-piece colored flame-retardant polyolefin heat-shrink kit, 2:1 ratio, assorted 1–13 mm sizes | 1 kit | Required | No | Listing specifications verified | Selected for the direct-soldered V1 wiring approach. Listing specifies flame-retardant polyolefin, 2:1 shrink ratio, approximately 84 °C minimum shrink temperature, 120 °C full shrink temperature and sizes including 2, 3 and 5 mm. Use the smallest tubing that slides over the joint before shrinking. Heating and soldering should be performed with appropriate adult supervision and ventilation. | TBD | Mercado Livre | https://www.mercadolivre.com.br/espaguete-isolante-termo-retratil-colorido-kit-560-pecas/up/MLBU3176050380 | Negligible | Electrical insulation
C-028 | Power / Protection | Resettable Fuse | Protect against overcurrent and short circuits | PTC resettable fuse sized for the 5 V / 3 A input; exact part pending | 1 | Pending verification | No | No | The MF-R110 1.1 A candidate is rejected as undersized for the approximately 2.64 A design allowance. Select the final protection device after startup/inrush and worst-case current testing. | TBD | TBD | TBD (https://www.digikey.com.br/en/products/detail/bourns-inc/MF-R110/259970) | Negligible | 5 V power protection
C-029 | Mechanical | Left Arm | Left cosmetic limb | Custom FDM 3D-printed left arm | 1 | Required | No | No | Print side-down with least-visible hand face toward the build plate | Pending print quote | 3D-print supplier | Pending supplier quote | TBD | Mechanical peg/socket
C-030 | Mechanical | Right Arm | Right cosmetic limb | Custom FDM 3D-printed right arm | 1 | Required | No | No | Print side-down with least-visible hand face toward the build plate | Pending print quote | 3D-print supplier | Pending supplier quote | TBD | Mechanical peg/socket
C-031 | Mechanical | Left Leg | Left seated support limb | Custom FDM 3D-printed left leg | 1 | Required | No | No | Print largest broad side on build plate | Pending print quote | 3D-print supplier | Pending supplier quote | TBD | Mechanical peg/socket
C-032 | Mechanical | Right Leg | Right seated support limb | Custom FDM 3D-printed right leg | 1 | Required | No | No | Print largest broad side on build plate | Pending print quote | 3D-print supplier | Pending supplier quote | TBD | Mechanical peg/socket
C-033 | Power | USB Wall Power Supply | Provide regulated power to the complete system | Xiaomi MDY-15-ET 67 W USB power adapter; normal output 5 V / 3 A | 1 | Required | Already owned | Label rating verified; complete-system load test pending | The existing original Xiaomi adapter label confirms a normal 5.0 V / 3.0 A output, matching the V1 5 V / 3 A requirement. Higher-voltage fast-charge modes are not used by the YG003 breakout. Verify stable operation and connector temperature during the complete-system current test. | Already owned | Existing Xiaomi adapter | — | TBD | AC mains to USB-A power adapter; 5 V / 3 A mode
C-035 | Wiring | USB-A to USB-C Power Cable | Connect the wall adapter to the YG003 USB-C input | Original Xiaomi USB-A to USB-C cable, 3 A-capable | 1 | Required | Already owned | Connector types visually verified; full-load test pending | Existing original cable has USB-A and USB-C ends and will carry only the main 5 V input. Confirm stable operation at the complete-system load and replace it if the voltage drops excessively or either connector becomes abnormally warm. | Already owned | Existing Xiaomi cable | — | TBD | USB-A to USB-C / 5 V power
C-034 | Wiring | 22 AWG Power/Audio Hook-Up Wire | Display, amplifier and ESP32 power; speaker connection | 22 AWG stranded copper silicone wire: red, black, yellow and blue | 2 m red + 2 m black + 1 m yellow + 1 m blue | Required | No | Specification selected; supplier pending | Use red for the display, amplifier and ESP32 positive power connections; black for their grounds; yellow for speaker positive; and blue for speaker negative. Purchase flexible stranded copper wire with silicone insulation. | TBD | Mercado Livre | https://produto.mercadolivre.com.br/MLB-6691549508-fio-eletrico-22awg-fios-de-silicone-flexiveis-5-cores-16-_JM | TBD | 5 V power / ground / amplified speaker output
C-036 | Wiring | 26 AWG Multicolored Signal Wire | I²S, UART and microphone signal wiring | 26 AWG stranded flexible silicone hook-up wire in six distinct colors | 1 kit (6 colors; 15 m total) | Required | No | Specification selected; supplier pending | Use red for 3.3 V, black for ground, yellow for shared I²S BCLK, blue for shared I²S WS/LRC, green for microphone SD or labelled Nextion TX, and white for amplifier DIN or labelled Nextion RX. The INMP441 bundle requires approximately 10–15 cm per main run, with L/R tied locally to ground. Reused colors must be labelled at both ends when they serve separate subsystems. Keep microphone wiring short and away from the speaker/amplifier route. Exact consumed lengths remain pending physical routing verification. | TBD | Mercado Livre | https://www.mercadolivre.com.br/kit-de-fio-de-silicone-26awg-de-6-cores-e-15-m/up/MLBU4915277962 | TBD | I²S / UART / 3.3 V signal power
C-037 | Wiring | 26 AWG 8-Conductor Ribbon Cable | Connect seven buttons plus their common ground | 26 AWG flexible 8-conductor ribbon cable | 1 m | Required | No | Specification selected; supplier pending | Use seven conductors for the individual button signals and one conductor for the shared ground. Confirm that the ribbon is flexible enough for the planned cable route before purchase. | TBD | Mercado Livre | https://www.mercadolivre.com.br/5mt-cabo-flat-colorido-8-vias-26awg--014mm--8x26-color/up/MLBU733429821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 | TBD | GPIO buttons / common ground
C-038 | Audio / Mechanical | Microphone Foam Gasket | Seal the microphone to the faceplate opening and reduce vibration | Approximately 2 mm soft closed-cell foam gasket, cut to a small ring around the acoustic port | 1 small piece | Required | No | Physical fit test pending | Bridge the approximately 1.864 mm gap between the INMP441 acoustic face and the faceplate. Keep the center sound path fully open; do not cover the MEMS port. Use light compression only so the PCB is not bent. | TBD | Local craft/electronics supplier | TBD | Negligible | Selected specification; supplier pending
C-039 | Audio / Mechanical | Acoustic Dust Mesh | Protect the microphone opening from dust without blocking sound | Thin acoustically transparent microphone/speaker mesh | 1 small piece | Optional | No | Acoustic test pending | Install over the faceplate slot only if it does not noticeably reduce voice-command sensitivity. Keep adhesive away from the acoustic path. Electronics-safe silicone may be used only as secondary retention if the physical fit test shows movement; it is not currently required as a separate purchase. | TBD | Local electronics/craft supplier | TBD | Negligible | Optional; verify after microphone test
C-040 | Setup Tools | USB Memory-Card Reader | Transfer Nextion firmware and assets between a computer and microSD card | USB-A multi-format Micro TF/SD/MS/M2 card reader, reference BNZ-E17557-67 | 1 | Required for setup | Yes — purchased locally | Read/write test pending | Locally purchased reader; not installed inside Project MO. Packaging identifies memory-card specification 2.0 support, Micro TF/SD/MS/M2 formats and an activity LED. After the microSD card arrives, confirm that the computer detects it, copy a test file, safely eject the card and verify the copied file can be read back. | TBD — local purchase | Local store | Not applicable — purchased locally | TBD | USB-A / removable memory-card reader
