heitordemoraesfagundes-star/Project_MO/hardware/enclosure/V1_Final/3MF_Final/Project_MO_Main_Body_V1.3mf.3mf

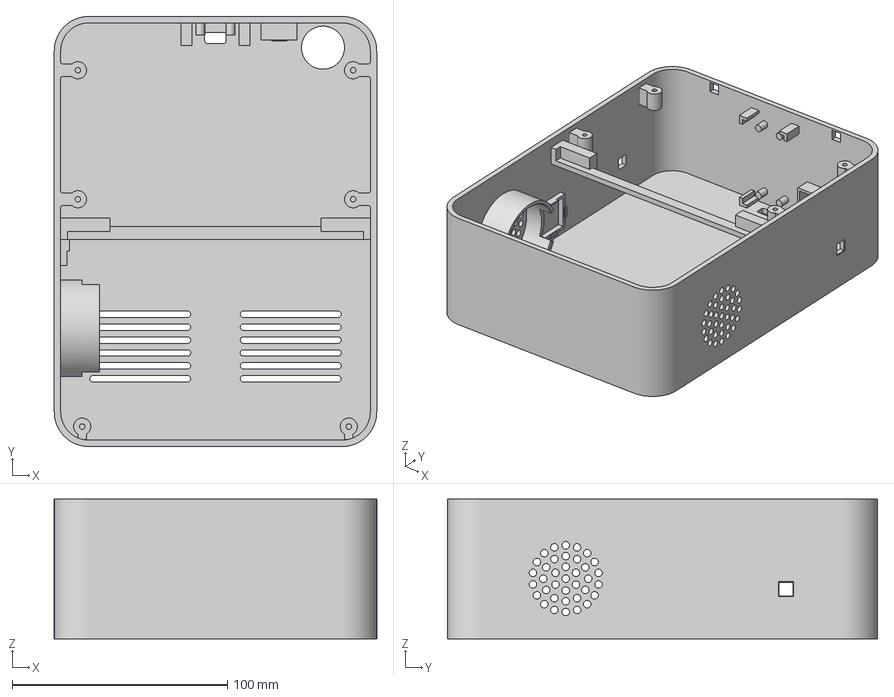
[picture p5: CAD file, 2026-10-10]
hardware/enclosure/V1_Final/3MF_Final/Project_MO_Main_Body_V1.3mf.3mf
150.0 x 200.0 x 65.0 mm
