heitordemoraesfagundes-star/Project_MO/hardware/enclosure/V1_Final/3MF_Final/Project_MO_Right_Arm_V1.3mf.3mf

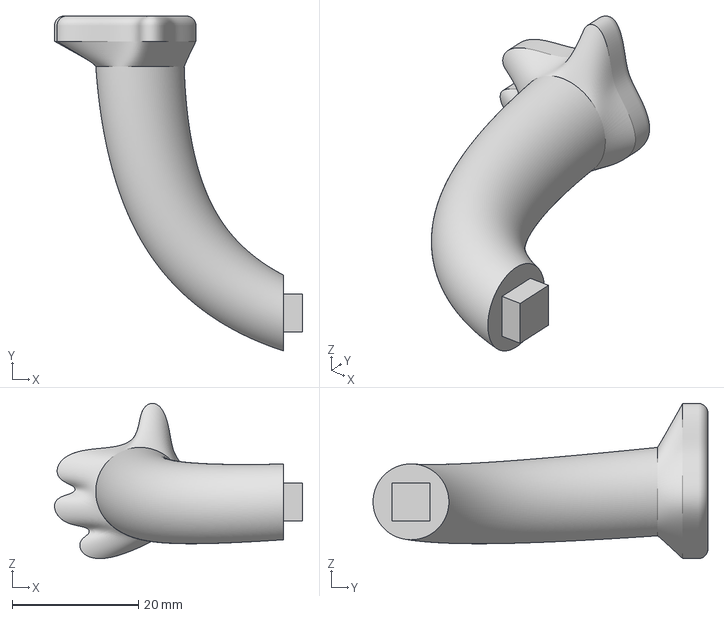
[picture p6: CAD file, 2026-10-10]
hardware/enclosure/V1_Final/3MF_Final/Project_MO_Right_Arm_V1.3mf.3mf
39.2 x 53.0 x 24.6 mm
