heitordemoraesfagundes-star/Project_MO/hardware/enclosure/V1_Final/test_coupons/Project_MO_V1_Fit_Test_Supplier_Package_Rev1.0/01_3MF_Models/Project_MO_V1_Microphone_Fit_Coupon.3mf

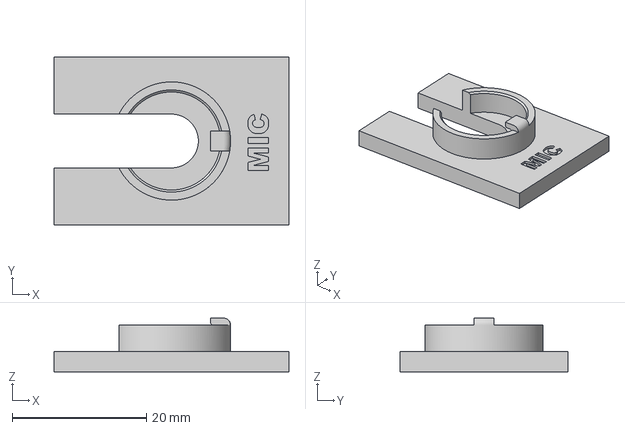
[picture p7: CAD file, 2026-10-10]
hardware/enclosure/V1_Final/test_coupons/Project_MO_V1_Fit_Test_Supplier_Package_Rev1.0/01_3MF_Models/Project_MO_V1_Microphone_Fit_Coupon.3mf
35.0 x 25.0 x 8.00 mm
