heitordemoraesfagundes-star/Project_MO/hardware/enclosure/V1_Final/test_coupons/Project_MO_V1_USB-C_Fit_Coupon.3mf

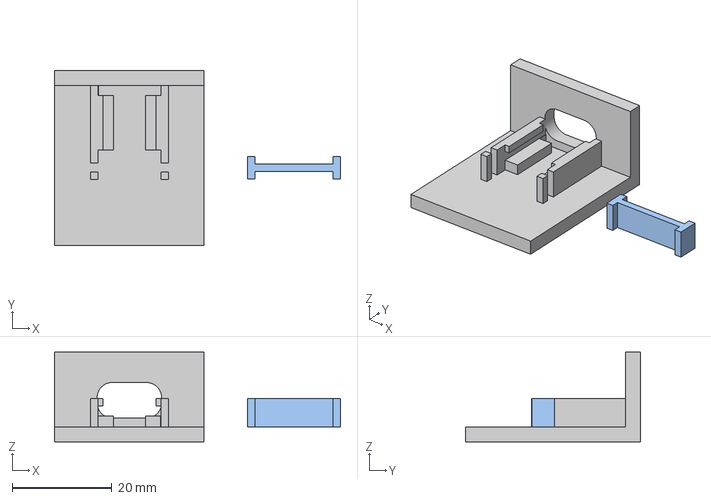
[picture p8: CAD file, 2026-10-10]
hardware/enclosure/V1_Final/test_coupons/Project_MO_V1_USB-C_Fit_Coupon.3mf
57.3 x 35.0 x 18.0 mm
USB_C_Coupon_Body
