heitordemoraesfagundes-star/Project_MO/research/Original_3D_print_design/buttontriangle_bmo.stl

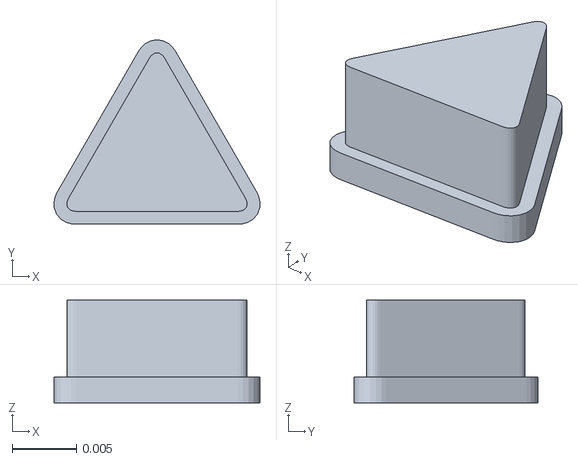
[picture p9: CAD file, 2026-08-15]
research/Original_3D_print_design/buttontriangle_bmo.stl
0.016 x 0.0143 x 0.008
