heitordemoraesfagundes-star/Project_MO/hardware/enclosure/V1_Final/3MF_Final/Perfboard_Retainer_Lower_Left.3mf

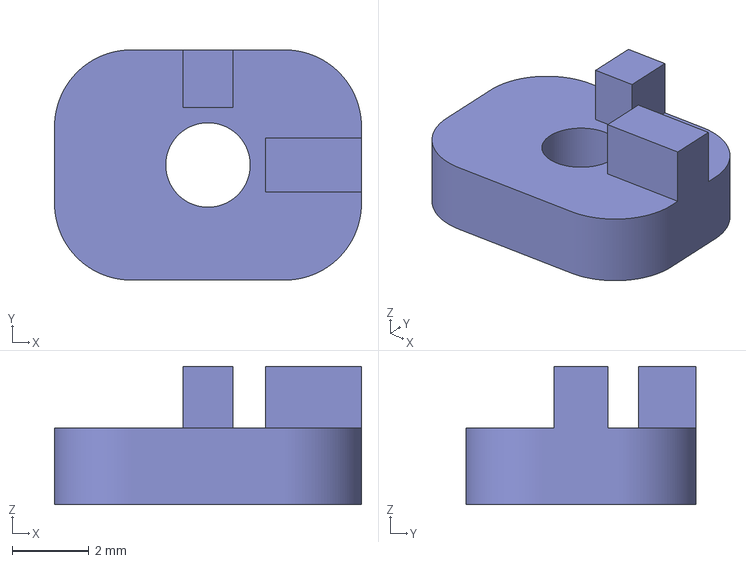
[picture p10: CAD file, 2026-10-10]
hardware/enclosure/V1_Final/3MF_Final/Perfboard_Retainer_Lower_Left.3mf
8.00 x 6.00 x 3.60 mm
