heitordemoraesfagundes-star/Project_MO/hardware/enclosure/V1_Final/test_coupons/Project_MO_V1_Limb_Interface_Fit_Coupon.3mf

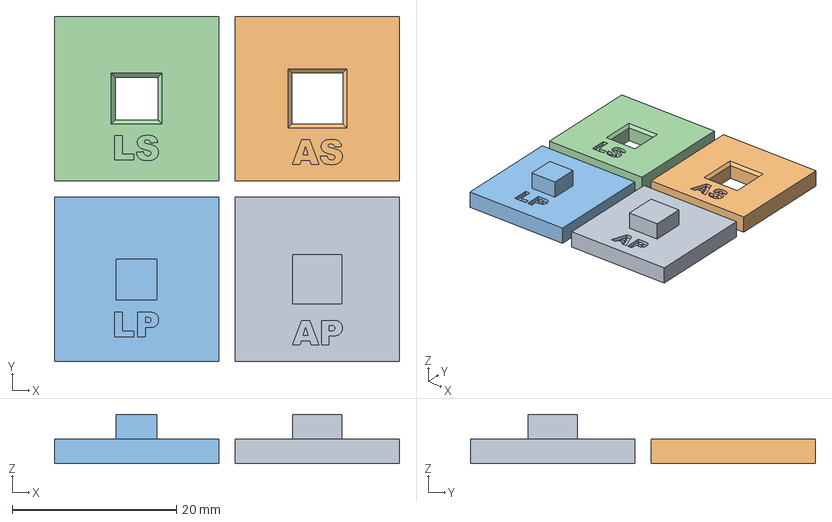
[picture p12: CAD file, 2026-10-10]
hardware/enclosure/V1_Final/test_coupons/Project_MO_V1_Limb_Interface_Fit_Coupon.3mf
42.0 x 42.0 x 6.00 mm
Arm_Peg_Test_Body
Arm_Socket_Test_Body
Leg_Peg_Test_Body
Leg_Socket_Test_Body
