heitordemoraesfagundes-star/Project_MO/research/Original_3D_print_design/legs_bmo.stl

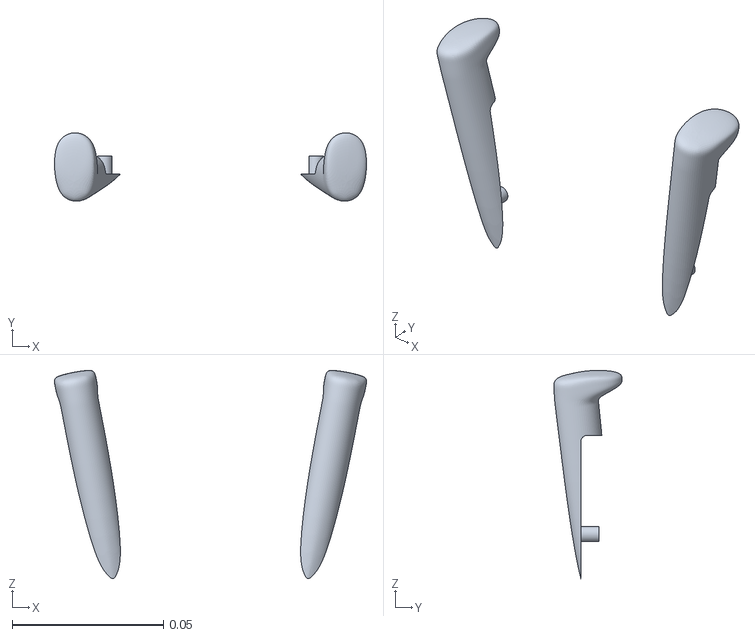
[picture p13: CAD file, 2026-08-15]
research/Original_3D_print_design/legs_bmo.stl
0.103 x 0.0226 x 0.0689
