heitordemoraesfagundes-star/Project_MO/hardware/enclosure/V1_Final/test_coupons/Project_MO_V1_Original_Button_Meshes.3mf

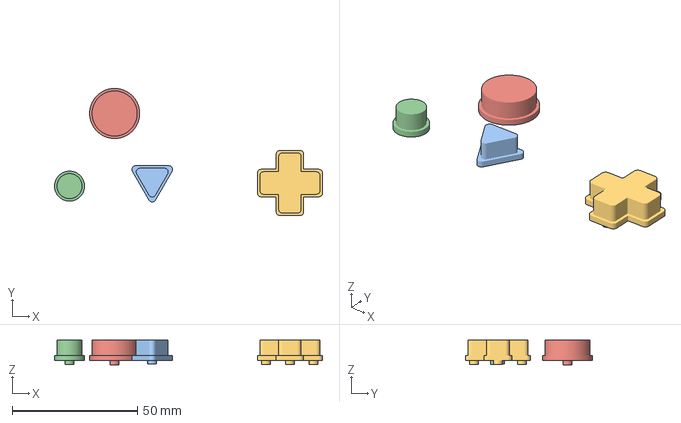
[picture p16: CAD file, 2026-10-10]
hardware/enclosure/V1_Final/test_coupons/Project_MO_V1_Original_Button_Meshes.3mf
107.0 x 50.8 x 9.80 mm
