heitordemoraesfagundes-star/Project_MO/research/Original_3D_print_design/dpad_bmo.stl

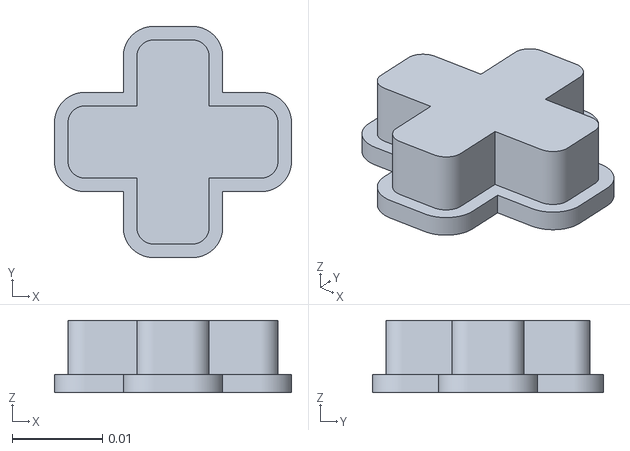
[picture p17: CAD file, 2026-08-15]
research/Original_3D_print_design/dpad_bmo.stl
0.0262 x 0.0256 x 0.008
