heitordemoraesfagundes-star/Project_MO/hardware/enclosure/V1_Final/3MF_Final/Project_MO_Small_Circular_Button_V1.3mf.3mf

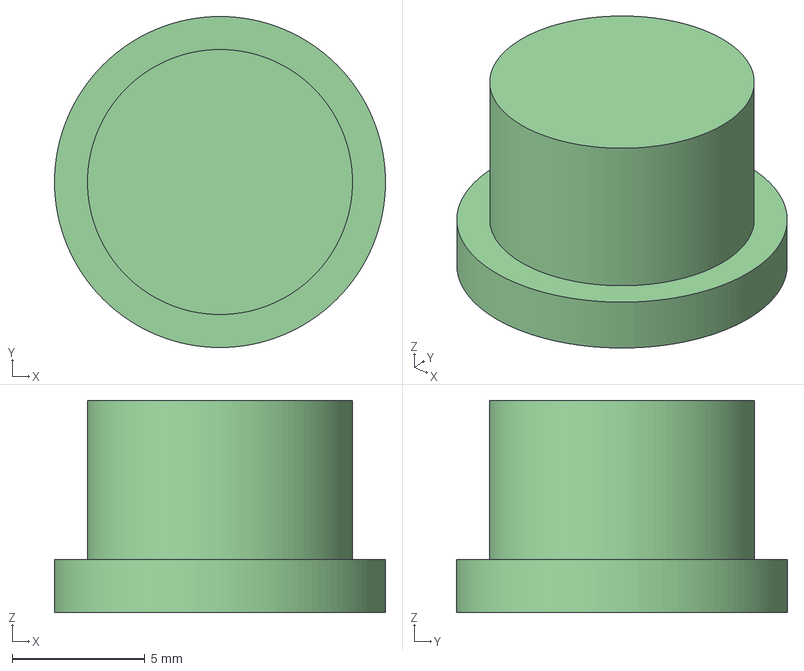
[picture p18: CAD file, 2026-10-10]
hardware/enclosure/V1_Final/3MF_Final/Project_MO_Small_Circular_Button_V1.3mf.3mf
12.5 x 12.5 x 8.00 mm
