heitordemoraesfagundes-star/Project_MO/hardware/enclosure/V1_Final/test_coupons/Project_MO_V1_Fastener_Fit_Coupon.3mf

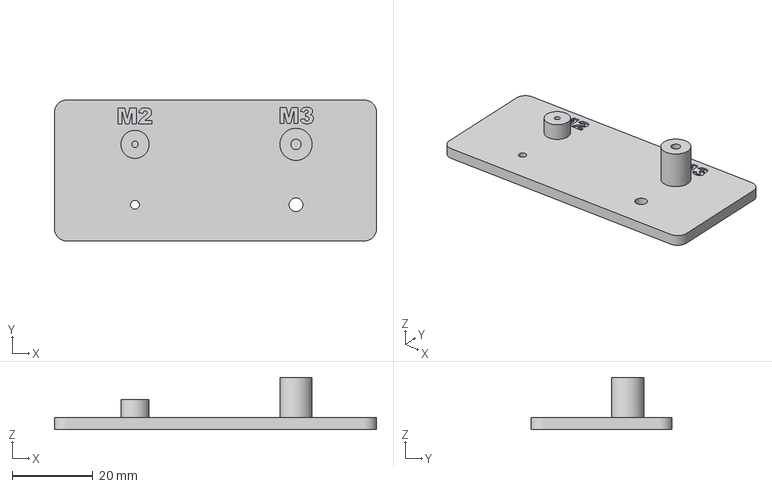
[picture p19: CAD file, 2026-10-10]
hardware/enclosure/V1_Final/test_coupons/Project_MO_V1_Fastener_Fit_Coupon.3mf
80.0 x 35.0 x 13.0 mm
