heitordemoraesfagundes-star/Project_MO/hardware/enclosure/V1_Final/test_coupons/Project_MO_V1_Fit_Test_Supplier_Package_Rev1.0/01_3MF_Models/Project_MO_V1_ESP32_Fit_Coupon.3mf

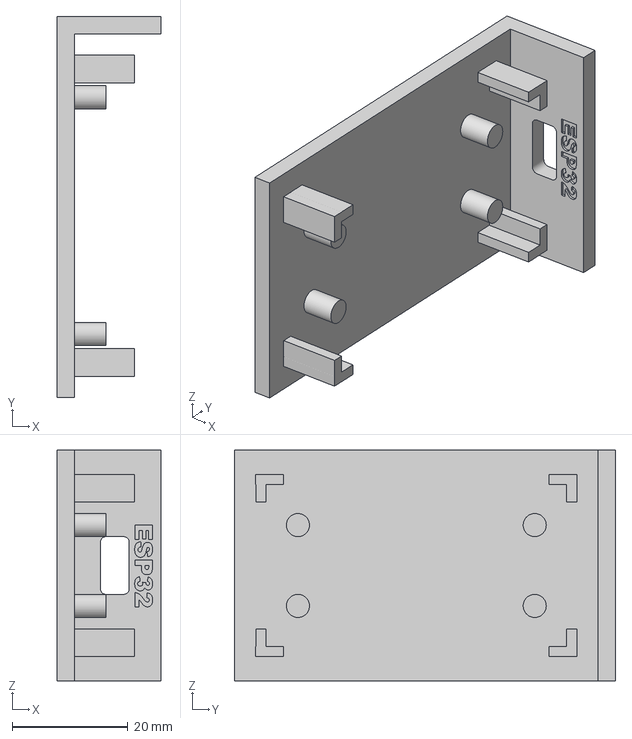
[picture p20: CAD file, 2026-10-10]
hardware/enclosure/V1_Final/test_coupons/Project_MO_V1_Fit_Test_Supplier_Package_Rev1.0/01_3MF_Models/Project_MO_V1_ESP32_Fit_Coupon.3mf
18.0 x 66.0 x 40.0 mm
