heitordemoraesfagundes-star/Project_MO/research/Original_3D_print_design/battery_bmo_case_v2.stl

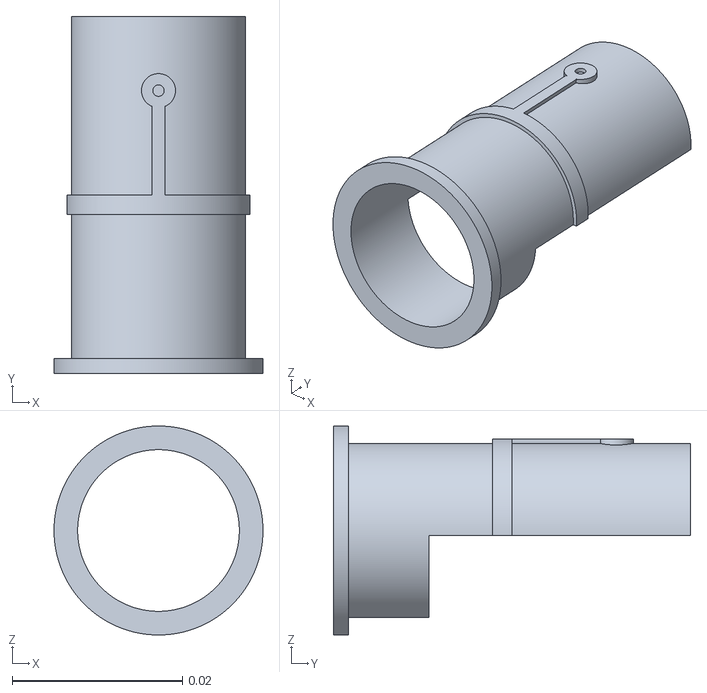
[picture p21: CAD file, 2026-08-15]
research/Original_3D_print_design/battery_bmo_case_v2.stl
0.0246 x 0.042 x 0.0246
