heitordemoraesfagundes-star/Project_MO/hardware/enclosure/V1_Final/3MF_Final/Project_MO_Right_Leg_V1.3mf.3mf

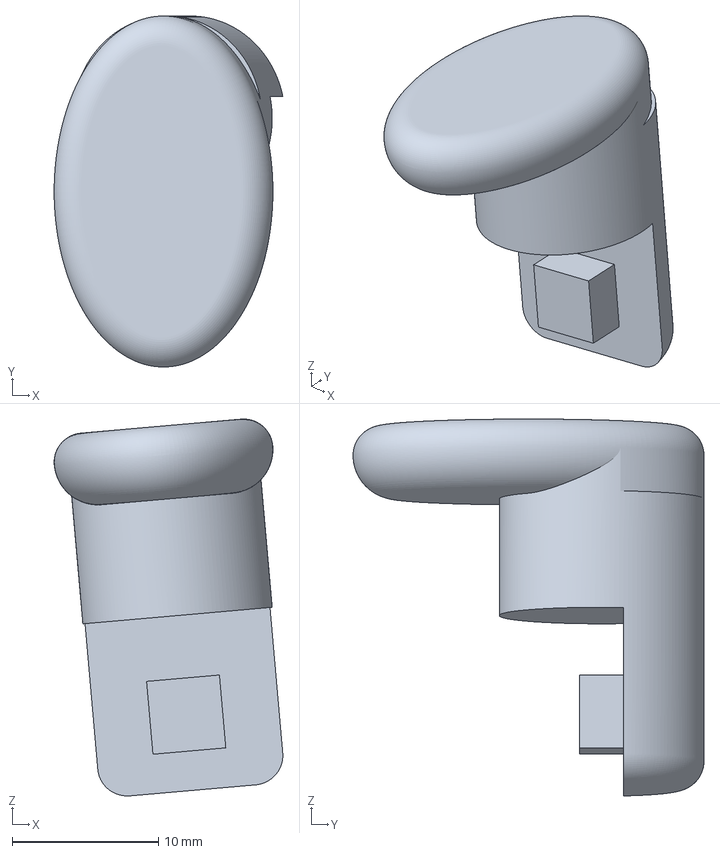
[picture p22: CAD file, 2026-10-10]
hardware/enclosure/V1_Final/3MF_Final/Project_MO_Right_Leg_V1.3mf.3mf
15.6 x 24.0 x 25.8 mm
