heitordemoraesfagundes-star/Project_MO/hardware/enclosure/V1_Final/test_coupons/Project_MO_V1_USB-C_Holder.3mf

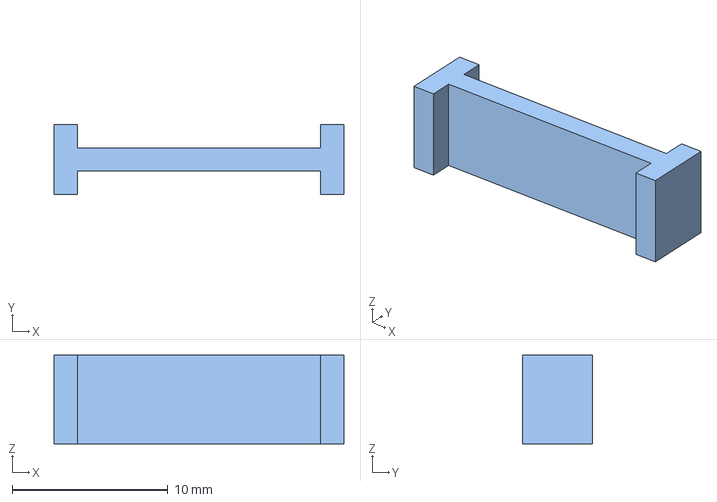
[picture p24: CAD file, 2026-10-10]
hardware/enclosure/V1_Final/test_coupons/Project_MO_V1_USB-C_Holder.3mf
18.6 x 4.50 x 5.70 mm
