heitordemoraesfagundes-star/Project_MO/research/Original_3D_print_design/infinitybox_bmo_case_v2.stl

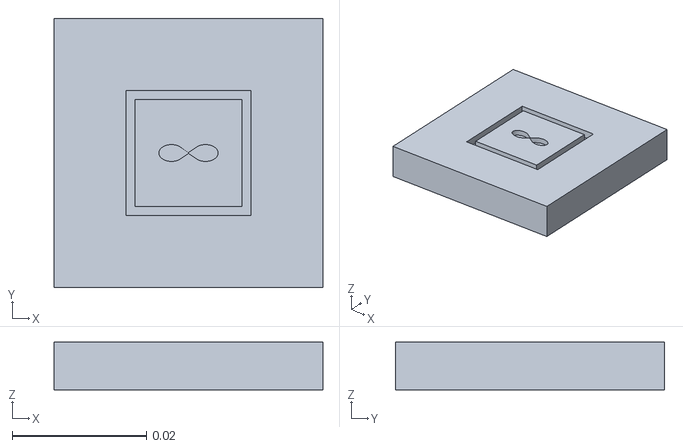
[picture p25: CAD file, 2026-08-15]
research/Original_3D_print_design/infinitybox_bmo_case_v2.stl
0.04 x 0.04 x 0.00713
