heitordemoraesfagundes-star/Project_MO/hardware/enclosure/V1_Final/test_coupons/Project_MO_V1_ESP32_Fit_Coupon.3mf

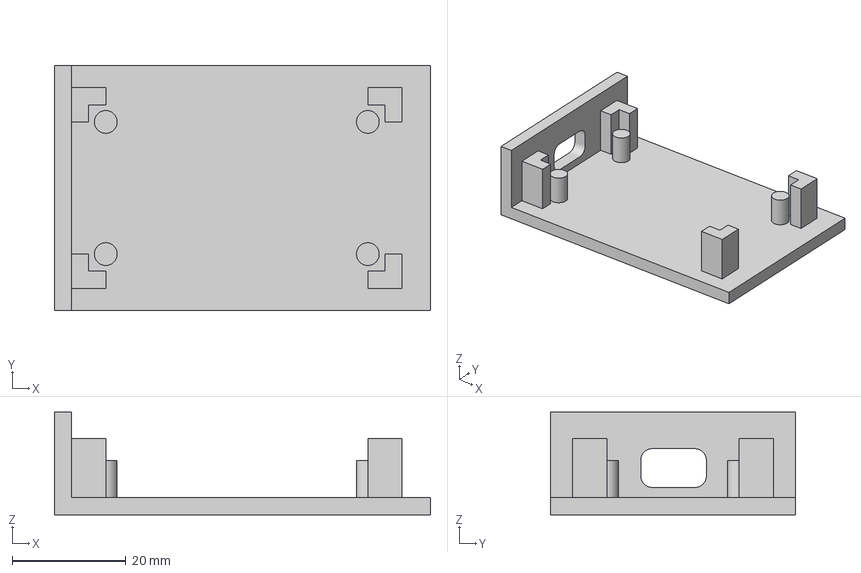
[picture p26: CAD file, 2026-10-10]
hardware/enclosure/V1_Final/test_coupons/Project_MO_V1_ESP32_Fit_Coupon.3mf
66.0 x 43.0 x 18.0 mm
