heitordemoraesfagundes-star/Project_MO/research/Original_3D_print_design/hatchdoor_bmo.stl

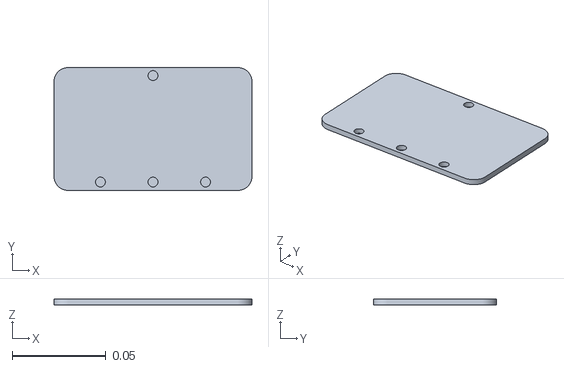
[picture p28: CAD file, 2026-08-15]
research/Original_3D_print_design/hatchdoor_bmo.stl
0.106 x 0.0655 x 0.003
