heitordemoraesfagundes-star/Project_MO/research/Original_3D_print_design/hatchframe_bmo.stl

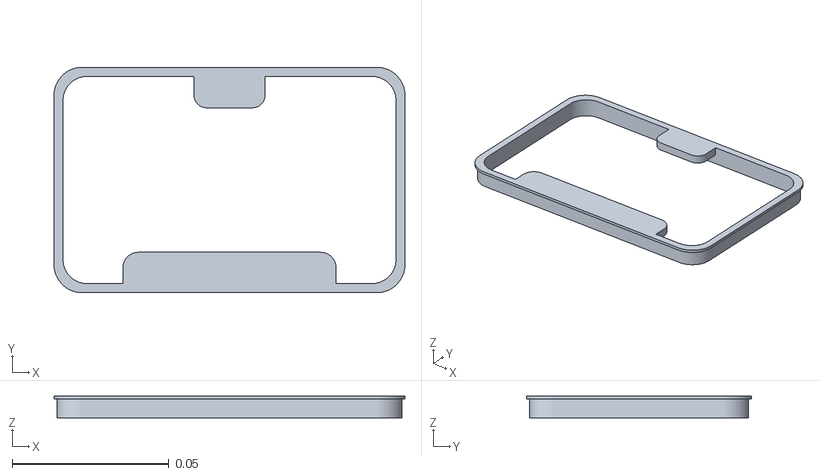
[picture p30: CAD file, 2026-08-15]
research/Original_3D_print_design/hatchframe_bmo.stl
0.112 x 0.0718 x 0.007
