heitordemoraesfagundes-star/Project_MO/research/Original_3D_print_design/arms_bmo.stl

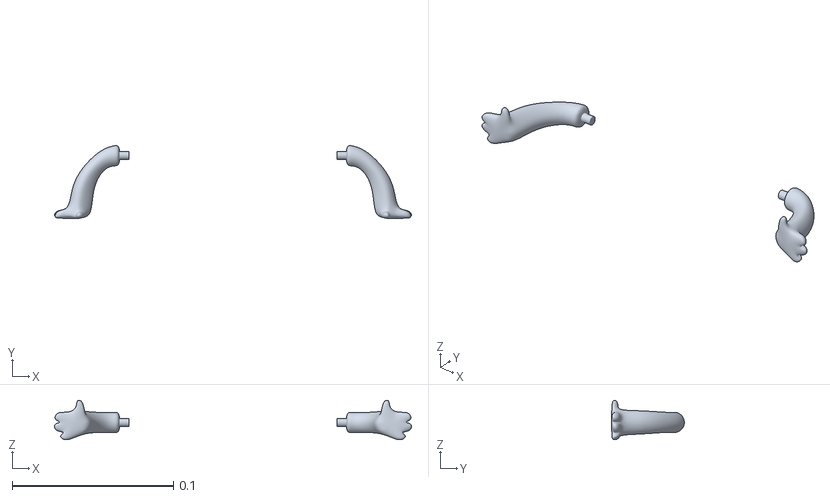
[picture p31: CAD file, 2026-08-15]
research/Original_3D_print_design/arms_bmo.stl
0.221 x 0.0451 x 0.0245
