heitordemoraesfagundes-star/Project_MO/hardware/enclosure/V1_Final/test_coupons/Project_MO_V1_Amplifier_Fit_Coupon.3mf

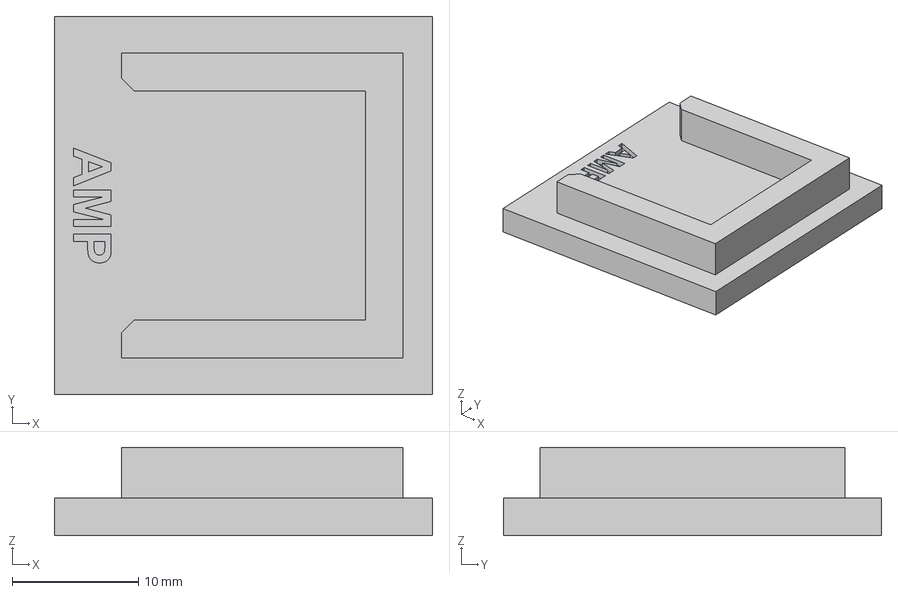
[picture p32: CAD file, 2026-10-10]
hardware/enclosure/V1_Final/test_coupons/Project_MO_V1_Amplifier_Fit_Coupon.3mf
30.0 x 30.0 x 7.00 mm
