heitordemoraesfagundes-star/Project_MO/research/Original_3D_print_design/medal_bmo_case_v2.stl

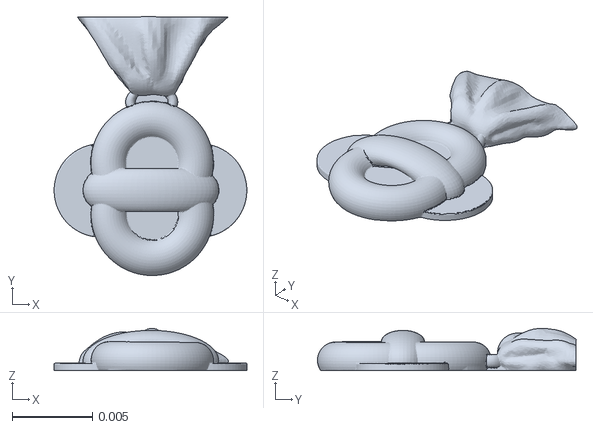
[picture p33: CAD file, 2026-08-15]
research/Original_3D_print_design/medal_bmo_case_v2.stl
0.012 x 0.0161 x 0.00262
