heitordemoraesfagundes-star/Project_MO/hardware/enclosure/V1_Final/3MF_Final/Project_MO_Triangle_Button_V1.3mf.3mf

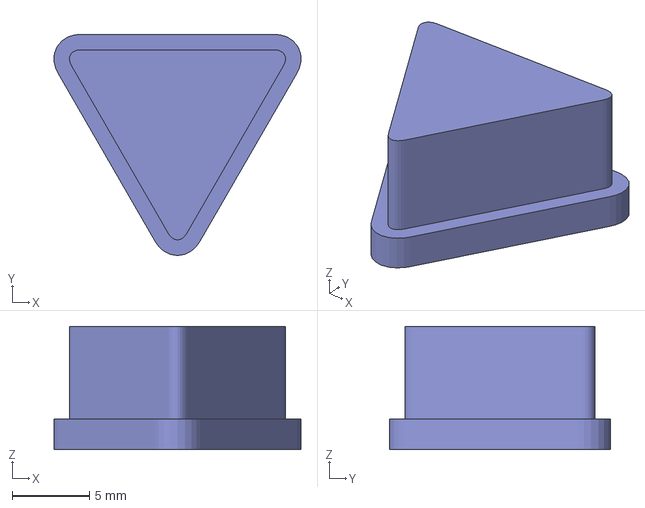
[picture p34: CAD file, 2026-10-10]
hardware/enclosure/V1_Final/3MF_Final/Project_MO_Triangle_Button_V1.3mf.3mf
16.0 x 14.3 x 8.00 mm
