heitordemoraesfagundes-star/Project_MO/research/Original_3D_print_design/text_bmo.stl

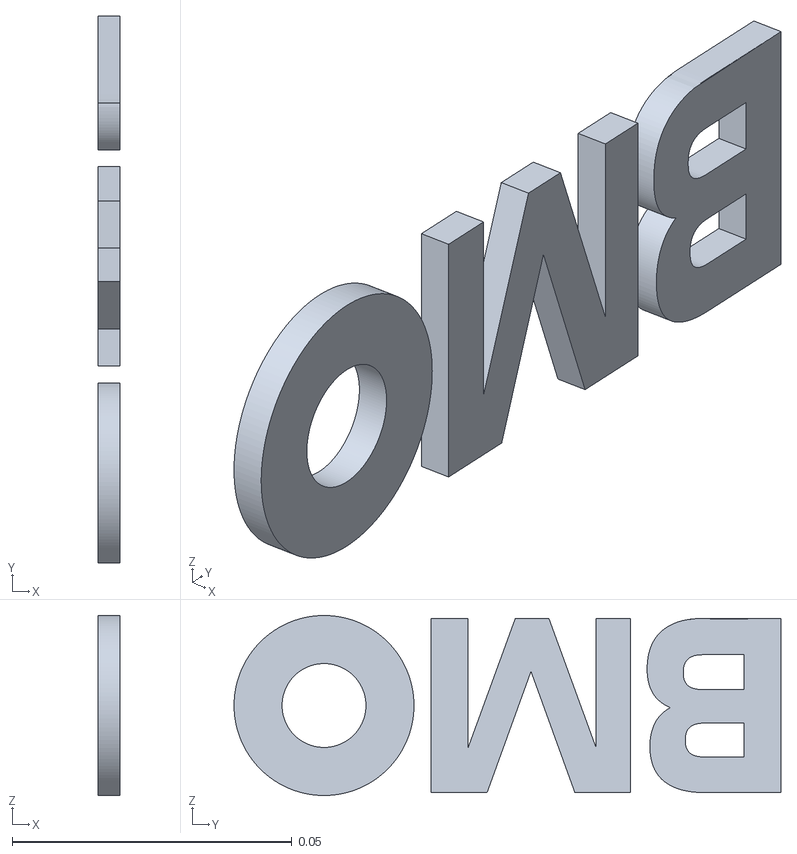
[picture p35: CAD file, 2026-08-15]
research/Original_3D_print_design/text_bmo.stl
0.004 x 0.0978 x 0.0322
