heitordemoraesfagundes-star/Project_MO/hardware/enclosure/V1_Final/3MF_Final/Project_MO_DPad_Center_Pivot_V1.3mf.3mf

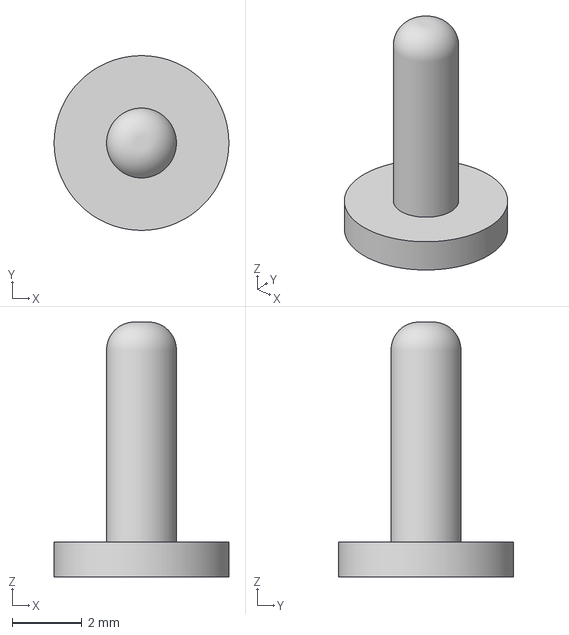
[picture p36: CAD file, 2026-10-10]
hardware/enclosure/V1_Final/3MF_Final/Project_MO_DPad_Center_Pivot_V1.3mf.3mf
5.00 x 5.00 x 7.30 mm
