heitordemoraesfagundes-star/Project_MO/hardware/enclosure/V1_Final/test_coupons/Project_MO_V1_Face_Plate_Fit_Coupon.3mf

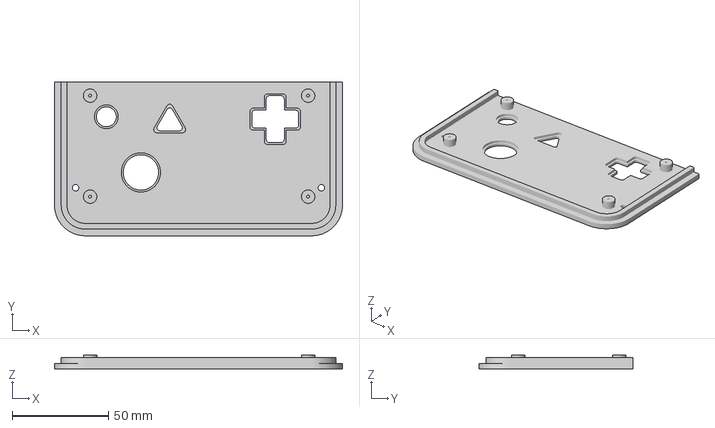
[picture p37: CAD file, 2026-10-10]
hardware/enclosure/V1_Final/test_coupons/Project_MO_V1_Face_Plate_Fit_Coupon.3mf
150.0 x 80.0 x 7.50 mm
