heitordemoraesfagundes-star/Project_MO/research/Original_3D_print_design/buttonbigcircle_bmo.stl

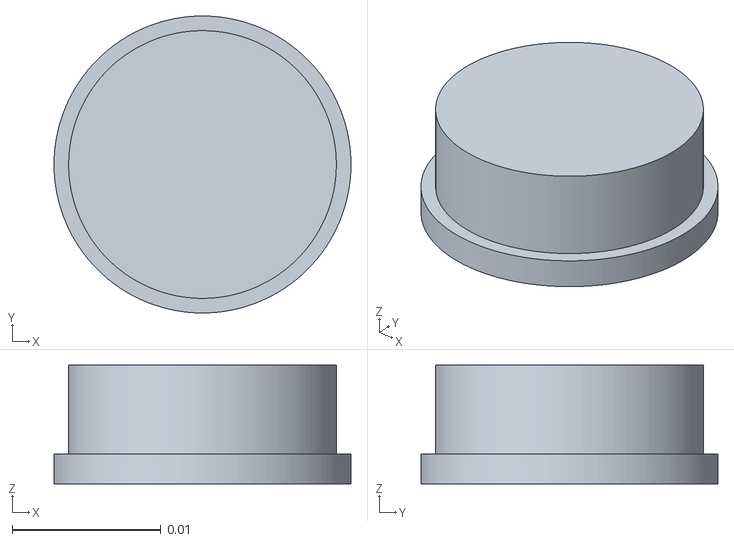
[picture p38: CAD file, 2026-08-15]
research/Original_3D_print_design/buttonbigcircle_bmo.stl
0.02 x 0.02 x 0.008
