heitordemoraesfagundes-star/Project_MO/hardware/enclosure/V1_Final/test_coupons/Project_MO_V1_Microphone_Fit_Coupon.3mf

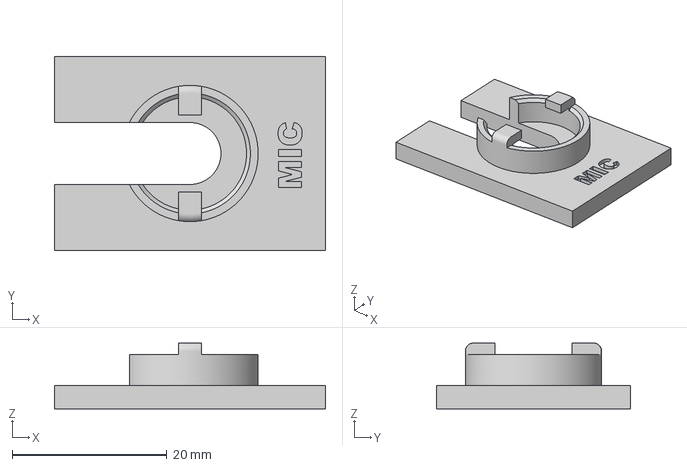
[picture p39: CAD file, 2026-10-10]
hardware/enclosure/V1_Final/test_coupons/Project_MO_V1_Microphone_Fit_Coupon.3mf
35.0 x 25.0 x 8.50 mm
