heitordemoraesfagundes-star/Project_MO/research/Original_3D_print_design/buttoncircle_bmo.stl

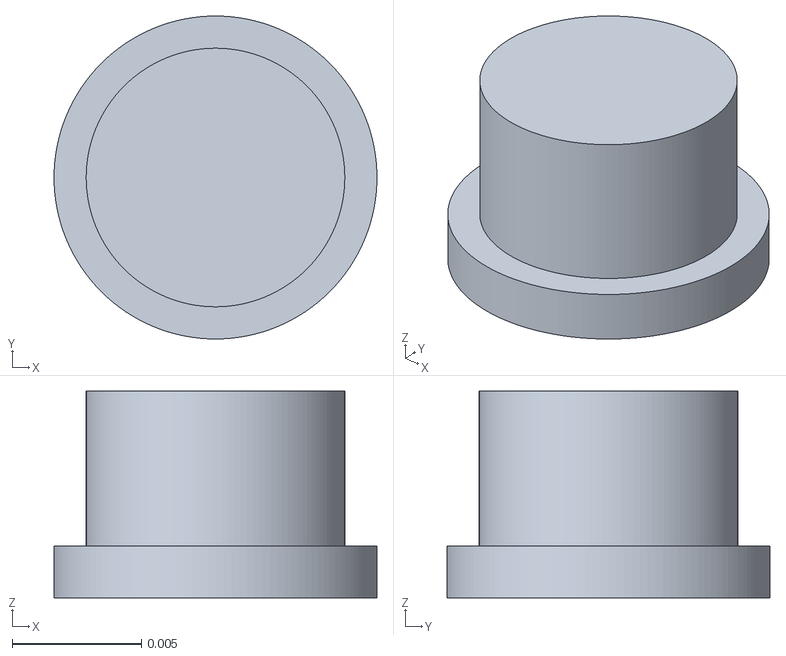
[picture p40: CAD file, 2026-08-15]
research/Original_3D_print_design/buttoncircle_bmo.stl
0.0125 x 0.0125 x 0.008
