heitordemoraesfagundes-star/Project_MO/hardware/enclosure/V1_Final/3MF_Final/Project_MO_DPad_Button_V1.3mf.3mf

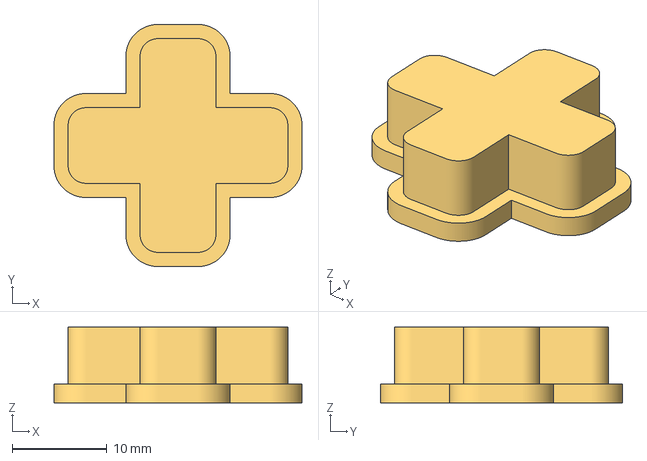
[picture p41: CAD file, 2026-10-10]
hardware/enclosure/V1_Final/3MF_Final/Project_MO_DPad_Button_V1.3mf.3mf
26.2 x 25.6 x 8.00 mm
