heitordemoraesfagundes-star/Project_MO/hardware/enclosure/V1_Final/3MF_Final/Project_MO_Display_Upper_Retainer_V1.3mf.3mf

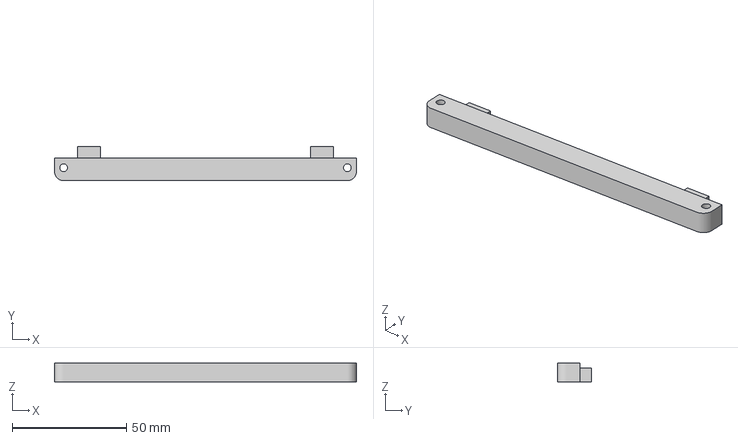
[picture p42: CAD file, 2026-10-10]
hardware/enclosure/V1_Final/3MF_Final/Project_MO_Display_Upper_Retainer_V1.3mf.3mf
132.0 x 15.0 x 8.20 mm
