heitordemoraesfagundes-star/Project_MO/hardware/enclosure/V1_Final/3MF_Final/Project_MO_FacePlate_V1.3mf.3mf

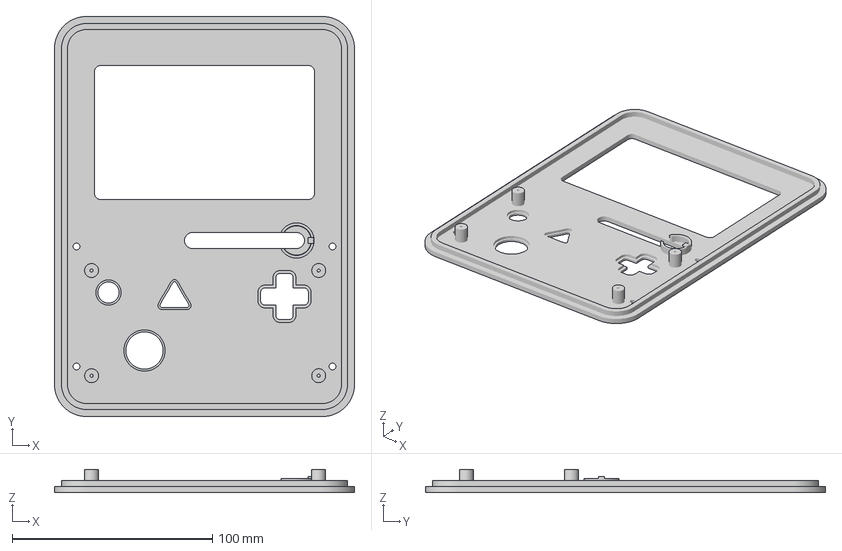
[picture p43: CAD file, 2026-10-10]
hardware/enclosure/V1_Final/3MF_Final/Project_MO_FacePlate_V1.3mf.3mf
150.0 x 200.0 x 11.5 mm
