heitordemoraesfagundes-star/Project_MO/(list of files, cad)

Other CAD files:
hardware/enclosure/V1_Final/3MF_Final/Perfboard_Retainer_Lower_Right.3mf
hardware/enclosure/V1_Final/3MF_Final/Perfboard_Retainer_Upper_Left.3mf
hardware/enclosure/V1_Final/test_coupons/Project_MO_Original_Button_Meshes.3mf
hardware/enclosure/V1_Final/3MF_Final/Project_MO_Left_Leg_V1.3mf.3mf
hardware/enclosure/V1_Final/test_coupons/Project_MO_V1_Speaker_Fit_Coupon.3mf
hardware/enclosure/V1_Final/3MF_Final/Perfboard_Retainer_Upper_Right.3mf
hardware/enclosure/V1_Final/test_coupons/Project_MO_V1_Switch_Fit_Coupon.3mf
hardware/enclosure/V1_Final/3MF_Final/Project_MO_Left_Arm_V1.3mf.3mf
hardware/enclosure/V1_Final/test_coupons/Project_MO_Face_Plate_Coupon.3mf
hardware/enclosure/V1_Final/Fusion_Source/Project_MO_V1_Manufacturing_Release.f3z
hardware/enclosure/V1_Final/Old_Versions/Project_MO_Display_Upper_Retainer_V1.1.3mf.3mf
hardware/enclosure/V1_Final/Old_Versions/Project_MO_Main_Body_V1.1.3mf.3mf
hardware/enclosure/V1_Final/test_coupons/Project_MO_V1_Fit_Test_Coupons_Complete.f3d
