heitordemoraesfagundes-star/Project_MO/docs/02_Design/Measurements.docx

Measurements:

Tactile Switch:

- Body_Width = 7.30mm;
- Body_Lenght = 7.30mm;
- Body_Height = 2.20mm;
- Total_Height = 6.60mm;
- Actuator_Width/Diameter = 4.00mm;
- Actuator_Height_Not_Pressed ~= 2.00mm;
- Actuator_Height_Pressed ~= 1.70mm;
- Pin_Spacing_Lenght ~= 4.4mm
- Pin_Spacing_Widht ~= 8.00mm

ESP32:

ESP32 Board:

- PCB_Lenght = 51.50mm
- PCB_Widht = 28.57-28.60mm
- Bare_PCB_Thickness ~= 1.60mm
- Maximum_Widht = Same as PCB Widht (Pins don’t go beyond the PCB)
- Total_Height_With_Pins ~= 13.00mm
- Total_Height = 4.85mm

USB Connector Position:

- Metal_Connector_Widht = 7.55mm
- Metal_Connector_Height = 2.60mm
- Distance_From_Left_Edge ~= 10.50mm
- Distance_From_Right_Edge ~= 10.50mm
- Center_Offset = 0.00mm
- Front_Face_To_Edge ~= 0.20mm
- Underside_To_Center ~= 2.90mm
- Top_Surface_To_Center ~= 1.30mm

Existing Mounting:

- Internal_Lenght = 52.00mm
- Internal_Widht = 28.00mm
- Base_To_Support_Height = 5.50mm
- Clip_Support_Vertical_Overlapp = 4.90mm
- Inner_Clip_Face_To_Wall= 5.5mm
- Outer_Face_To_Wall = 3.70mm
- USB_Connector_To_Outer_Wall = 6.70mm

USB Opening:

- Opening_Widht = 10.00mm
- Opening_Height = 5.00mm
- Opening_Wall_Thickness = 3.00mm

Actual Cable Plug:

- Plug_Widht ~= 6.80mm
- Plug_Height ~= 1.85mm
- Plug_Height_With_Clip = 2.35mm
- Exposed_Metal_Lenght ~= 6.20mm
- Plastic_Overmould_Width = 10.90mm
- Plastic_Overmould_Height = 6.20mm
- Plastic_Overmould_Lenght = 30.50

Amplifier:

PCB:

- PCB_Lenght = 18.75mm
- PCB_Widht = 17.60mm
- Bare_PCB_Thickness = 1.65mm
- Total_Lenght = Same as PCB_Length
- Total_Widht = Same as PCB_Widht
- Maximum_Height=2.50mm

Green Screw Terminal:

- Widht = 7.45mm
- Lenght = 6.75mm
- Height = 8.70mm
- Pin_Spacing ~= 3.50mm
- Pin_Height ~= 3.30mm
- Wire_Hole ~= 2.00mm

Yellow Pin Header:

- Widht = 17.75mm
- Length = 2.50mm
- Full_Height = 11.20mm
- Height_To_Plastic_Body = 8.40mm
- Pin_Pitch ~= 2.54mm

Mounting Hole:

- Hole_Diameter = 2.75mm
- Distance_From_Side_Edge = 1.25mm
- Distance_From_Top_Edge = 1.10mm
- Hole_Center_To_Center ~= 12.80mm

Amplifier Mounting:

- Internal_Widht = 17.40mm
- Internal_Lenght = 17.40mm
- Base_To_Support_Height = 3.00mm
- Side_Wall_Thickness = 3.00mm
- Base_Thickness = 3.00mm

ON/OFF Switch:

Switch Component:

- Body_Diameter: 18.00mm
- Body_Diameter_With_Side_Tab = 19.90mm
- Side_Tab_Lenght = 2.10mm
- Side_Tab_Height = 10.30mm
- Side_Tab_Widht = 1.90mm
- Tab_To_Flange = 2.30mm
- Retaining_Arm_Lenght = 3.80mm
- Retaining_Arm_Height = 15.00mm
- Retaining_Arm_Maximum_Width = 2.20mm
- Retaining_Arm_Compressed_Widht = 1.00mm
- Body_Maximum_Diameter_Relaxed_Arms = 22.40mm
- Retaining_Arm_To_Flange = 4.50mm
- Body_Diameter_Compressed_Arm = 20.00mm
- Body_Depth: 15.00mm
- Total_Body_Depht = 16.60mm
- Front_Flange_Diameter: 23.00mm
- Front_Flange_Widht: 1.60mm

Mounting Hole:

- Hole_Diameter = 19.80mm
- Hole_Depht = 3.00mm

USB-C:

- PCB_Length = 14.90mm
- PCB _Widht = 11.80 mm
- PCB_Height = 1.60mm
- USB-C_Outward_Projection = 1.40mm
- USB-C_Lenght = 7.45mm
- USB-C_Widht = 8.90mm
- USB-C_Height = 3.00 ~ 3.10mm
