heitordemoraesfagundes-star/Project_MO/docs/Development_Log/Project Log.docx

Project Log:

Entry #001-Project Beginning:

Date: July 31, 2026

#Reason for starting:

I wanted to explore how engineering could bring to life a fictional character design and have a project that could inspire me to learn more about the basics of engineering and the process behing engineering proccesses.

#Initial Goals:

-create an interactive robot prototype;

-develop a custom electronic system;

-learn embedded programming;

-document the engineering process.

#Current challenges:

-defining realistic project scope;

-selecting appropriate hardware;

-balancing complexity and available resources;

-working with a tight schedulle.

Entry #002-Engeneering decisions:

Date: August 1, 2026

#Topic: Main controller settings and components:

-Problem;

The robot requires a microcontroller capable of handling multiple peripherals while remaining affordable and easy to program.

-Alternatives considered:

*Arduino Uno;

*Raspberry Pi 5;

*ESP32 DevKit V1

-Decision: ESP32;

-Reasoning:

The ESP32 provides integrated Wi-Fi, Bluetooth, sufficient GPIO pins, and excellent community support while remaining significantly cheaper than a Raspberry Pi.

#Design principles:

1. Maintainability First – Any major component should be replaceable without damaging the enclosure.
2. Modularity – Components should be mounted independently whenever possible.
3. Simplicity Over Complexity – Prefer simple, reliable solutions over clever but fragile ones.
4. Educational Value – Every subsystem should teach a new engineering concept.
5. Professional Documentation – Every design change must have a documented reason.

Entry #003-Product Desgin Specifications(PDS):

Date: August 2, 2026

#Topic: Writing of the PDS document:

Entry #004-Bill of Material(BOM):

Date: August 3, 2026

#Topic: Chosing the exact components:

-Components file:

*components.xlsx

Entry #005-BOM Expansion:

Date: August 4, 2026

#Topic: Refining the Bill of Material(BOM)

## Accomplishments

Today's session was primarily focused on refining the project's Bill of Materials (BOM) and identifying any remaining hardware decisions before purchasing components.

## Progress

- Reviewed and refined the Bill of Materials.
- Identified remaining hardware components and assembly materials.
- Selected the preferred internal wiring specification.
- Evaluated audio amplifier alternatives.
- Defined the priorities for the next development session.

## Next Session Goals

- Complete the remaining BOM entries.
- Finalize supplier options and specifications.
- Create the GitHub repository structure.
- Draft the project README.
- Begin designing the project's branding and logo.

Entry #006 BOM Final Version:

Date: August 6, 2026

#Topic:Finishing the BOM

- Completed the remaining component entries C-017 to C-026 in the Component Database and added C-027 (Resettable PTC Fuse).
- Defined the subsystems, purposes, quantities, interfaces, and recommendation levels for the newly added components.
- Reviewed the BOM for missing components and made several small corrections and documentation improvements.
- Established the initial GitHub repository folder structure, separating documentation, BOM files, hardware, firmware, assets, media, and tools.
- Organized the existing project documents into Planning and Design categories:
  - PRD
  - EDR
  - System Design Document
  - HSD
  - MDS
- Decided that each major document should remain as a separate file rather than combining them into one document.
- Chose Project MO as the current project name.
- Developed the initial logo direction by combining the PCB-inspired Concept 3 with the friendly screen/face Concept 4, creating a logo concept that represents both engineering and the project's approachable personality.
- Discussed the project's initial visual identity and color palettes, with Mint + Charcoal currently being the preferred direction.
